crls-design/M8-Minima/docs/notes/design review.xlsx

Sheet: Schematic
Sheet | Area | Checked | Against | Notes
top | architecture
 | interconnection
power map | every rail accounted for
 | sequencing
 | peripheral levels
power input | port pinout | 2026-08-30
 | pd sink config | 2026-08-30 | datasheet | https://doc.chipmall.com/datasheet/rev_2412151944_hynetek-husb237-aa001-dn06r_c22909579.pdf
 | pd sink connection | 2026-08-30
 | buck feedback | 2026-08-30
 | buck bootstsrap | 2026-08-30
 | buck compensation | 2026-08-30
 | decoupling caps | 2026-08-30
pmic | input voltage bypass | 2026-08-30 | design checklist & evk | https://fscdn.rohm.com/en/products/databook/applinote/ic/power/switching_regulator_system/bd71847amwv_platformdesign_an-e.pdf
 | output bypass caps | 2026-08-30
 | pull ups | 2026-08-30
 | crystal | 2026-08-30
 | pinout | 2026-09-03 | datasheet
m8 power | symbol pinout | 2026-08-30 | datasheet
 | bypass caps | 2026-08-30 | evk
m8 io | symbol pinout | 2026-08-30 | datasheet
 | lpddr4 dq swapping | 2026-08-19 | RPA sheet | download here https://community.nxp.com/t5/i-MX-Processors-Knowledge-Base/i-MX-8M-Family-DDR-Tool-Release/ta-p/1104467
 | lpddr4 dqs dmi matched | 2026-08-21
 | lpddr4 channel ctrl addr matched | 2026-08-21
 | lpddr4 pinout | 2026-08-21 | datasheet table 69 | search for LPDDR4 keyword
 | ddr pin delay | 2026-08-21 | hardware guide | https://docs.nxp.com/bundle/IMX8MMHDG/page/topics/imx_8m_mini_ddr_package_delay.html
 | lpddr4 ref resistor | 2026-08-21 | design checklist | https://docs.nxp.com/bundle/IMX8MMHDG/page/topics/design_checklist_table.html
 | tsensor | 2026-08-21 | evk
 | usb ref resistor | 2026-08-19 | design checklist | https://docs.nxp.com/bundle/IMX8MMHDG/page/topics/design_checklist_table.html
 | vbus | 2026-08-19 | pintool | screenshot embedded
 | usb1 pinout | 2026-08-19 | pintool | screenshot embedded
 | usb2 pinout | 2026-08-19 | pintool | screenshot embedded
 | pcie pinout | 2026-08-19 | pintool | screenshot embedded
 | pcie ref resistor | 2026-08-21 | design checklist | https://docs.nxp.com/bundle/IMX8MMHDG/page/topics/design_checklist_table.html
 | uart pinout | 2026-08-21 | pintool | screenshot embedded
 | ethernet pinout | 2026-08-26 | pintool | screenshot embedded
 | i2c1 pinout | 2026-08-19 | pintool | screenshot embedded
 | i2c1 pull ups to NVCC I2C (pmic) | 2026-08-19 | pmic design checklist | pull ups located on pmic sheet
 | sd1 pinout | 2026-08-19 | pintool | screenshot embedded
 | sd2 pinout | 2026-08-19 | pintool | screenshot embedded
 | crystal resonator | 2026-08-21 | evk schematic
 | io level matched | 2026-08-21
m8 boot config | jtag pullups | 2026-08-30 | evk
 | jtag pins | 2026-08-30
 | boot mode | 2026-08-31 | datasheet
 | boot config | 2026-08-31 | datasheet
lpddr4 ram | symbol pinout | 2026-08-21 | datasheet
 | power | 2026-08-21
 | harness | 2026-08-21
 | odt | 2026-08-21 | hardware guide
 | zq | 2026-08-21 | hardware guide
ethernet | symbol pinout | 2026-08-21 | datasheet
 | jack termination | 2026-08-21
 | rgmii level | 2026-08-21
 | bootstraping | 2026-08-21
 | reset | 2026-08-21
 | regulator | 2026-08-21
flash | symbol pinout | 2026-08-21
 | emmc power | 2026-08-21
 | emmc pinout | 2026-08-21
 | sd power | 2026-08-21
 | sd pinout | 2026-08-21
 | pull ups | 2026-08-21
usb hub | symbol pinout | 2026-08-21 | datasheet
 | reset | 2026-08-21
 | power | 2026-08-21
 | bootstrap | 2026-08-21 | checklist
 | ref resistor | 2026-08-21 | checklist
 | diff pair polarity | 2026-08-21
 | usb detect | 2026-08-21
 | test pin | 2026-08-21 | checklist
 | crystal | 2026-08-21 | stm evk | https://www.st.com/resource/en/schematic_pack/mb1936-mp257f-x-d01-schematic.pdf
usb device port | symbol pinout | 2026-08-21 | datasheet
 | cc lines | 2026-08-21
 | polarity | 2026-08-21
 | vbus | 2026-08-21
usb host port | symbol pinout | 2026-08-21 | datasheet
 | cc lines | 2026-08-21
 | polarity | 2026-08-21
 | vbus | 2026-08-21
 | power switch | 2026-08-21 | datasheet
 | current limit | 2026-08-21
pcie | usb pinout | 2026-08-21
 | pcie pinout | 2026-08-21
 | sidebands | 2026-08-21
 | io level | 2026-08-21
 | pull resistors | 2026-08-21
uart | polarity | 2026-08-21
 | uart direction | 2026-08-21
 | power | 2026-08-21
 | io level | 2026-08-21
 | tx ac coupling | 2026-08-21

Sheet: Layout
Area | Checked | Against | Notes

Sheet: Today
2026-09-07
