crls-design/M8-Minima/docs/schematic.pdf

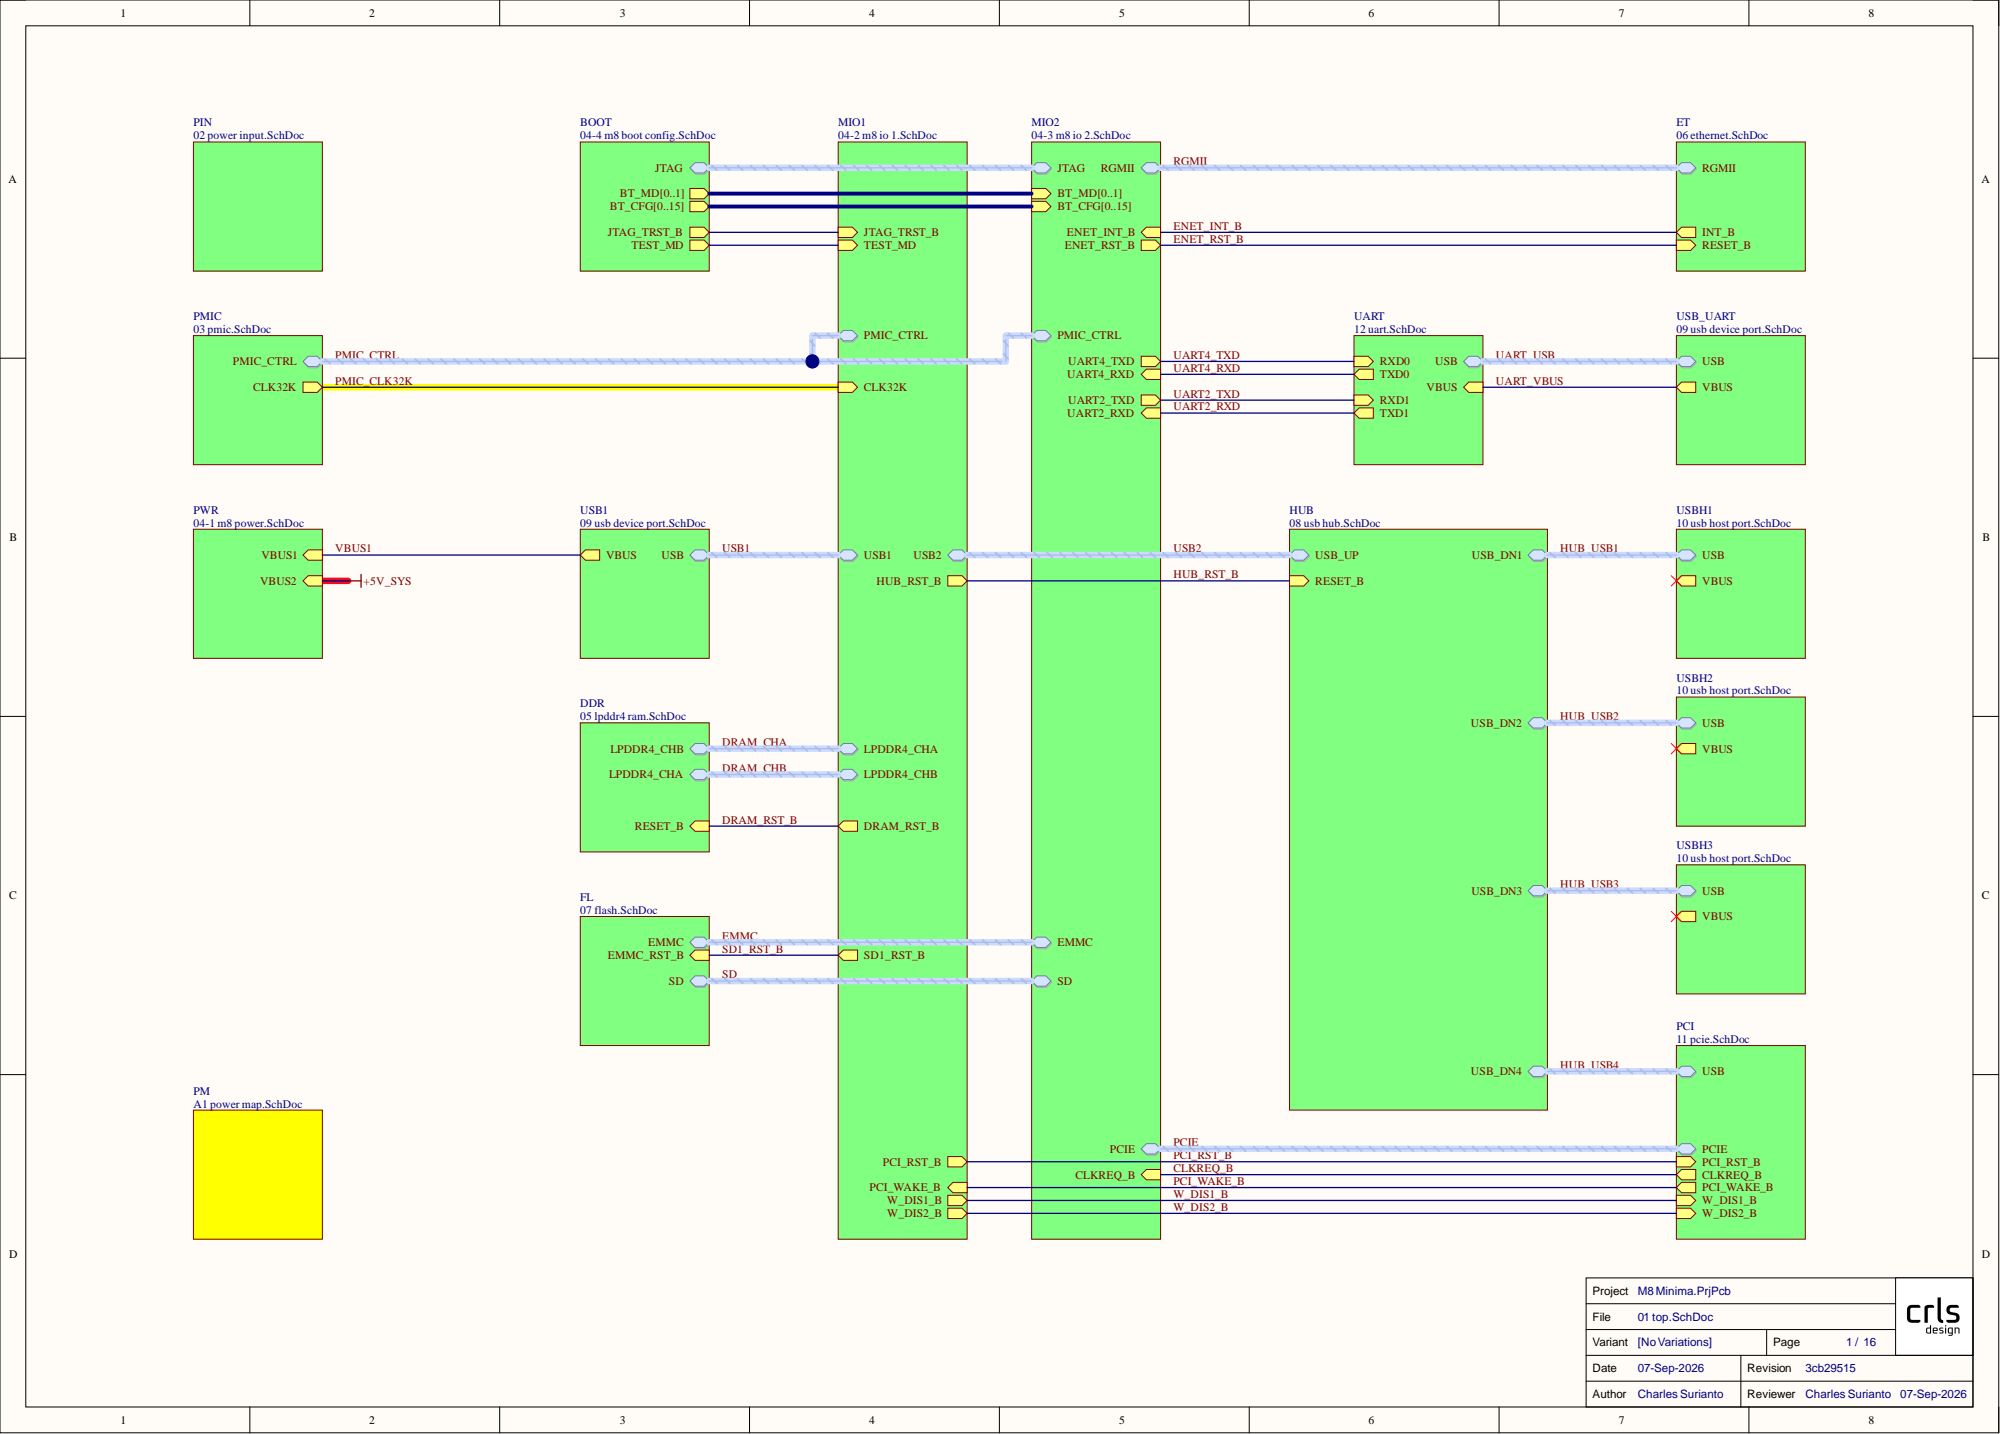
[picture p5: page 1]

JTAG_TRST_B TEST_MD PMIC_CTRL

USB_UART
09 usb device port.SchDoc

PMIC_CLK32K | UART4_RXD | UART_VBUS

USB1

USBH1
10 usb host port.SchDoc

USBH2

USBH3

W_DIS1_B
W_DIS2_B

Variant [No Variations] | Page

Date 07-Sep-2026 | Revision 3cb29515

Author Charles Surianto | Reviewer Charles Surianto 07-Sep-2026

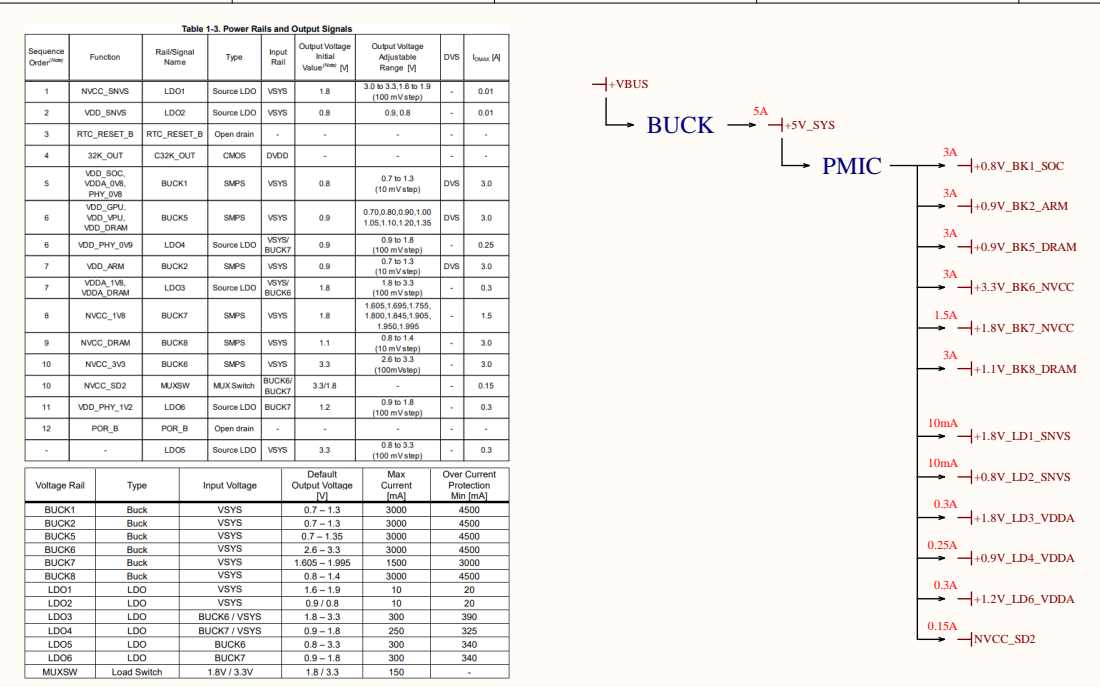
[picture p6: page 2]

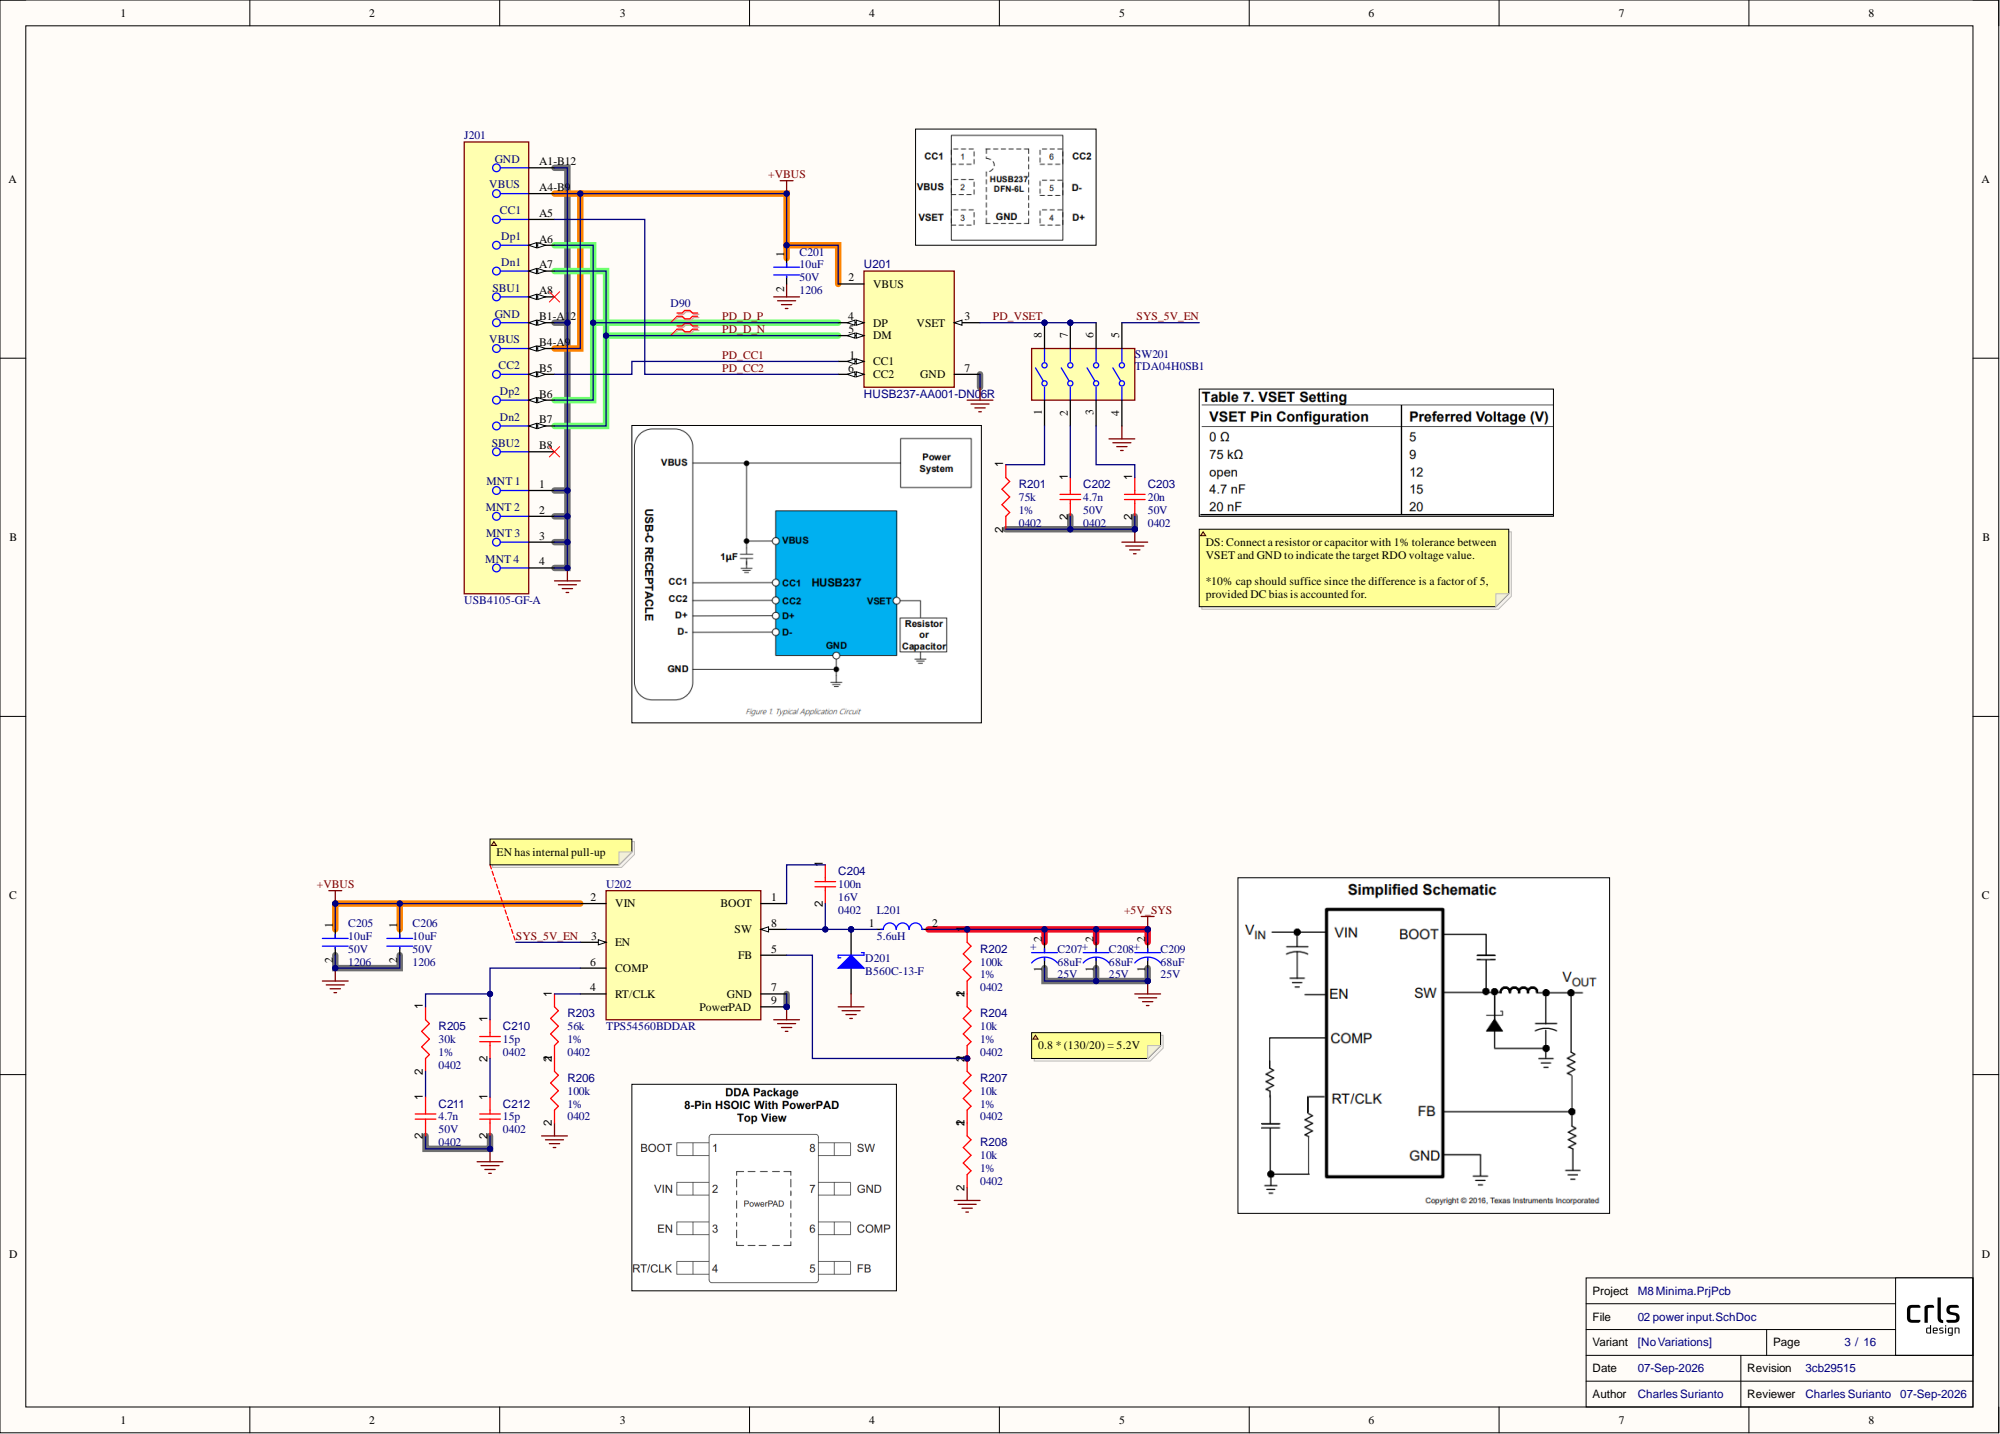
[picture p7: page 3]

PD_CC1 | CC1 1
PD_CC2

DS: Connect a resistor or capacitor with 1% tolerance between
VSET and GND to indicate the target RDO voltage value.

*10% cap should suffice since the difference is a factor of 5,
provided DC bias is accounted for.

EN has internal pull-up

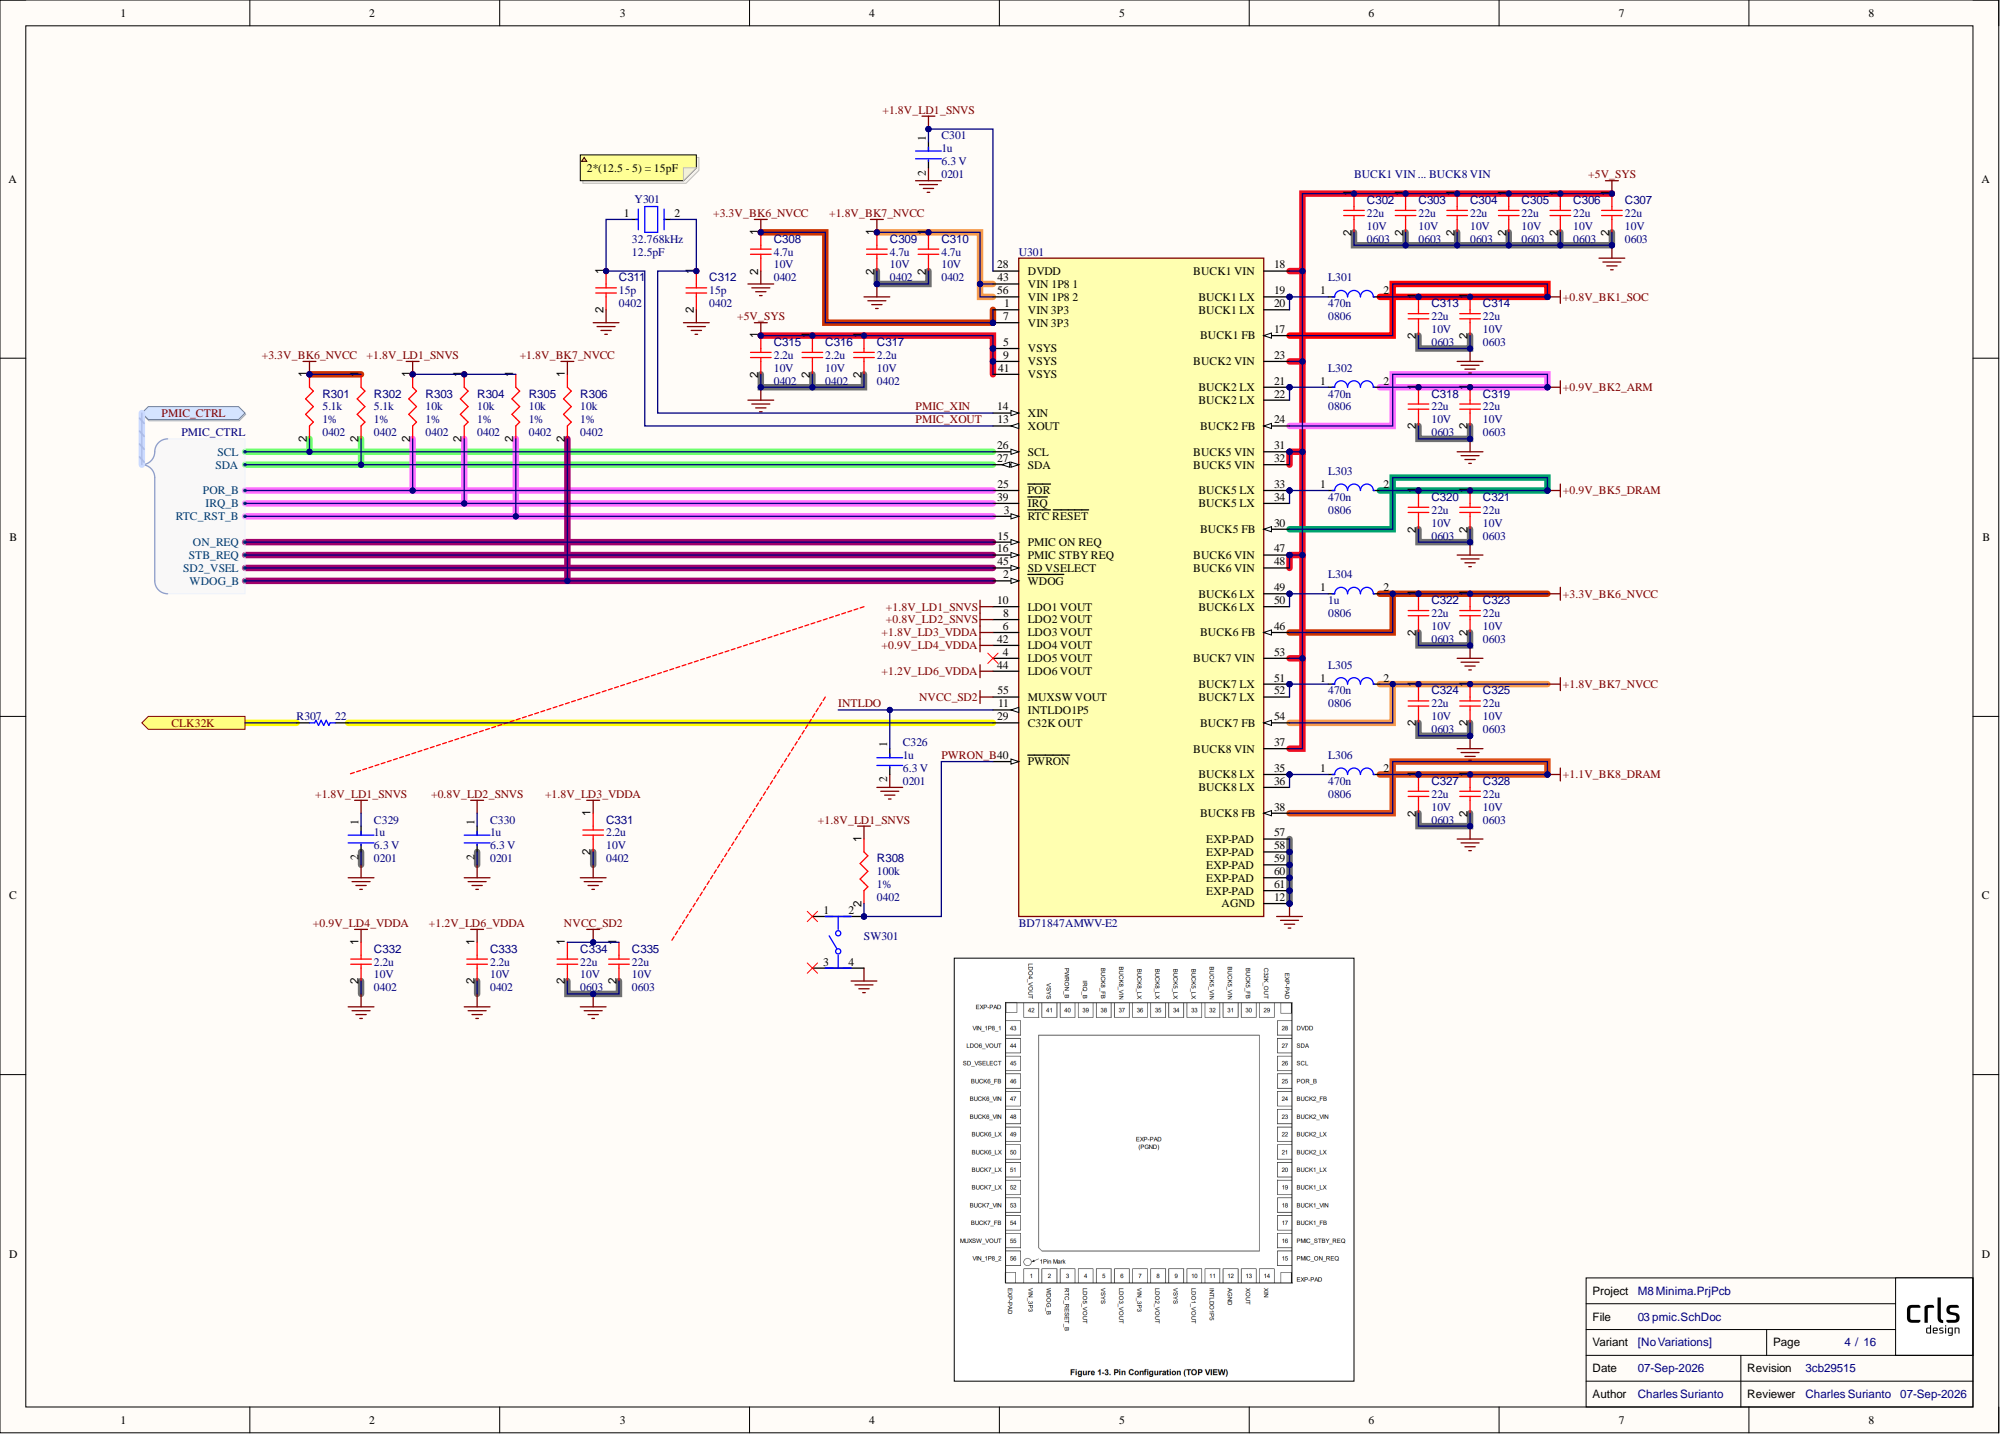
[picture p8: page 4]

2 5 | 3 3 3 4
3 | 3 0

4 5 | 4 8
2 | 4 9

5 1
5 2 | 4 7 0 n 0 8 0 6

Varian t [ No Variations ]

Dat | Revis i o n

Autho r | Review e Charles Suriant o 07-Sep-202

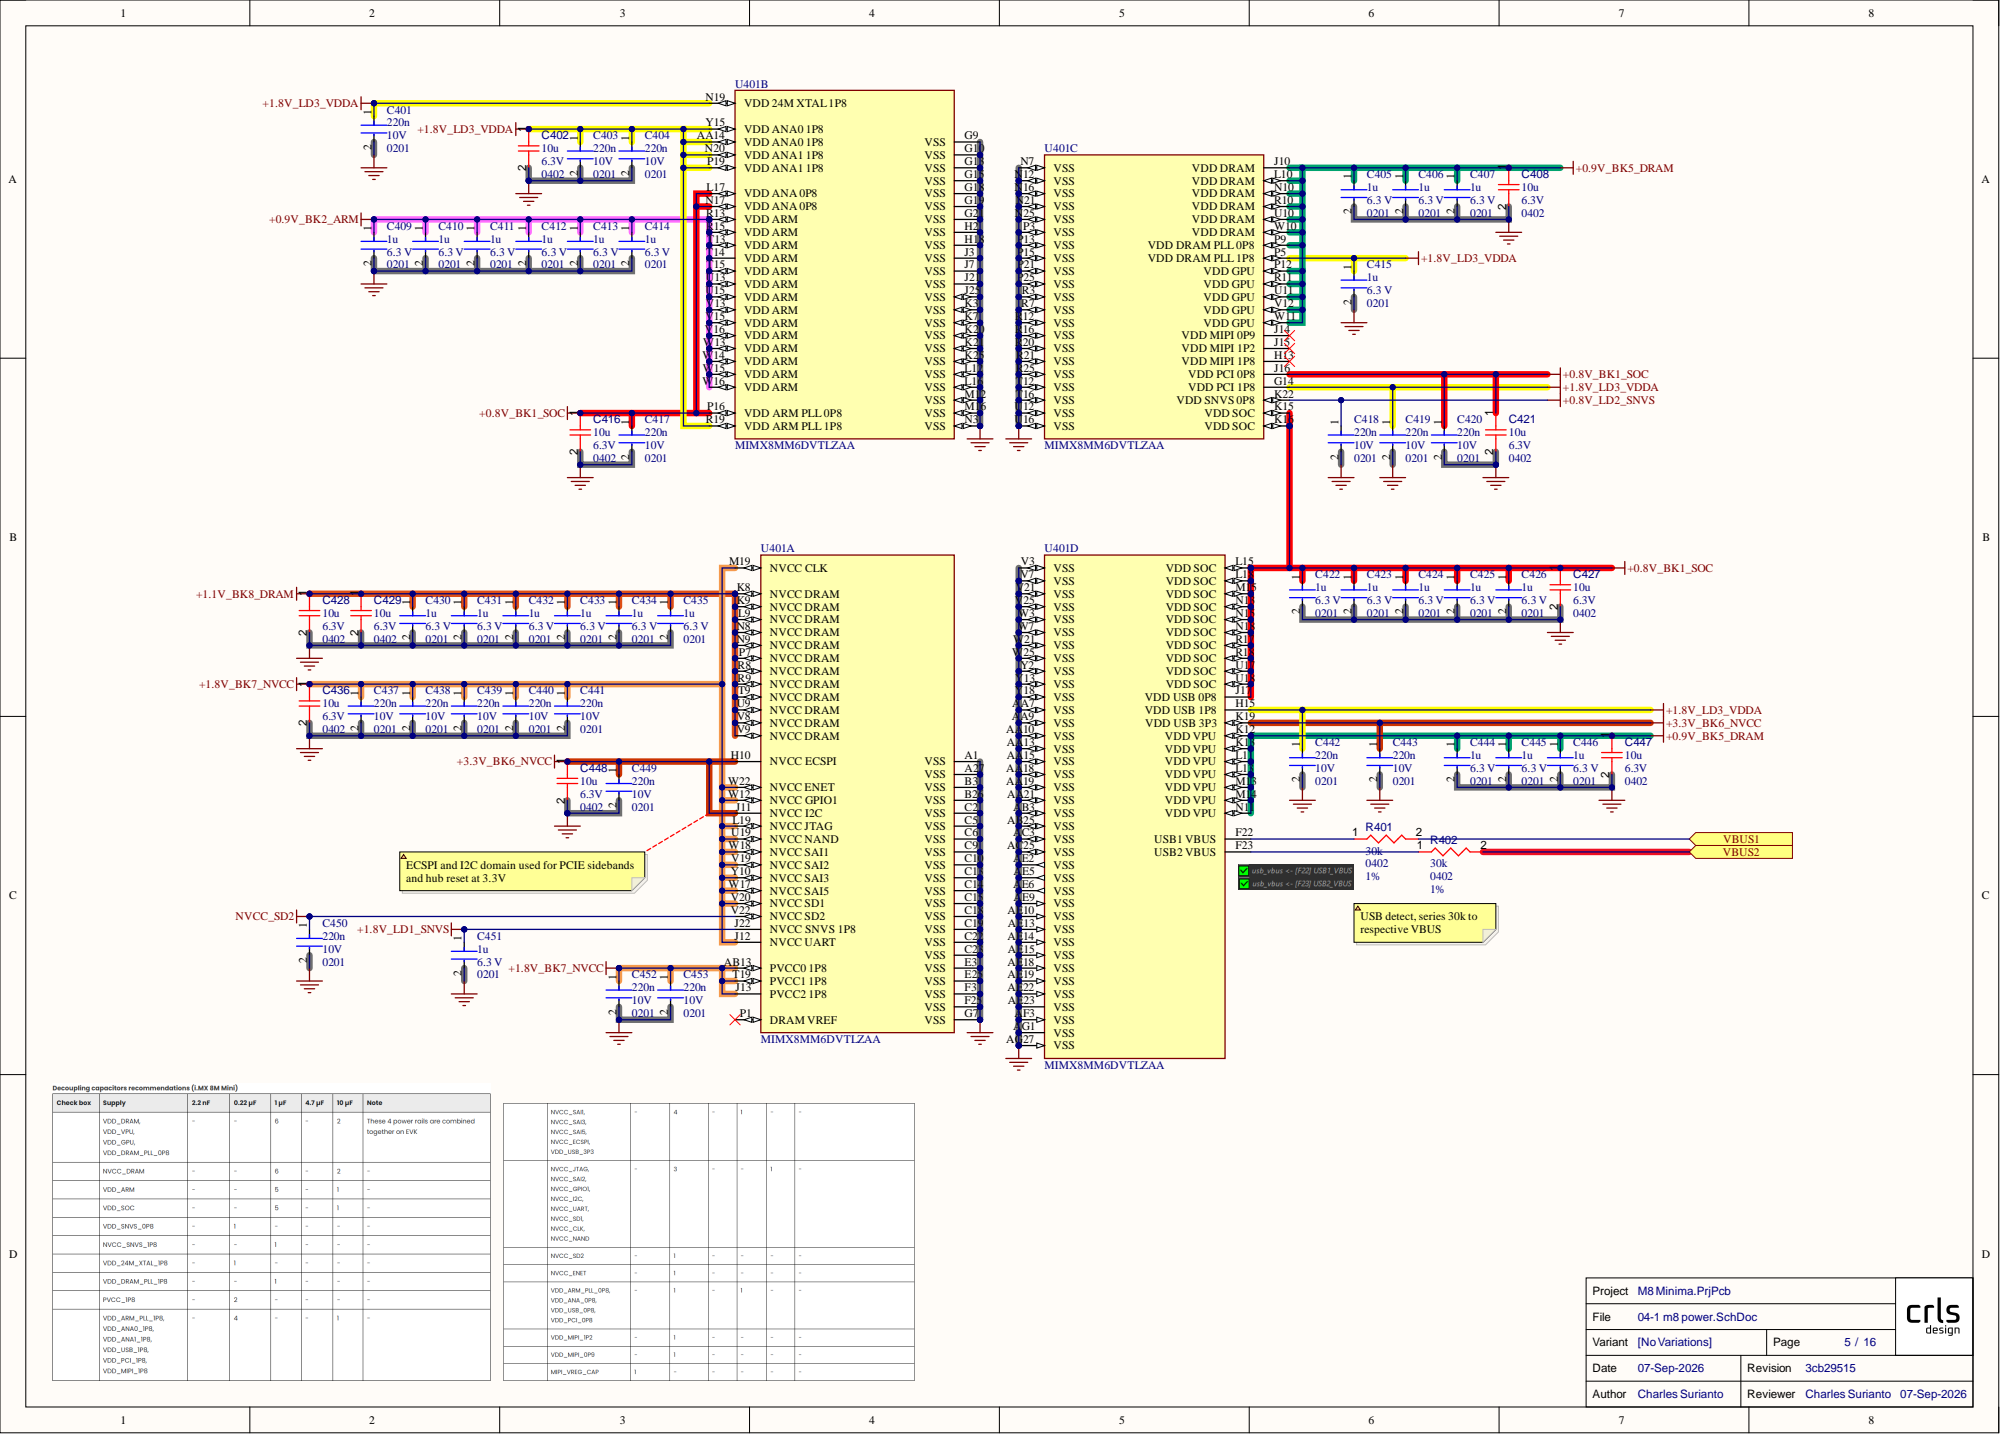
[picture p9: page 5]

ECSPI and I2C domain used for PCIE sidebands
and hub reset at 3.3V

USB detect, series 30k to
respective VBUS

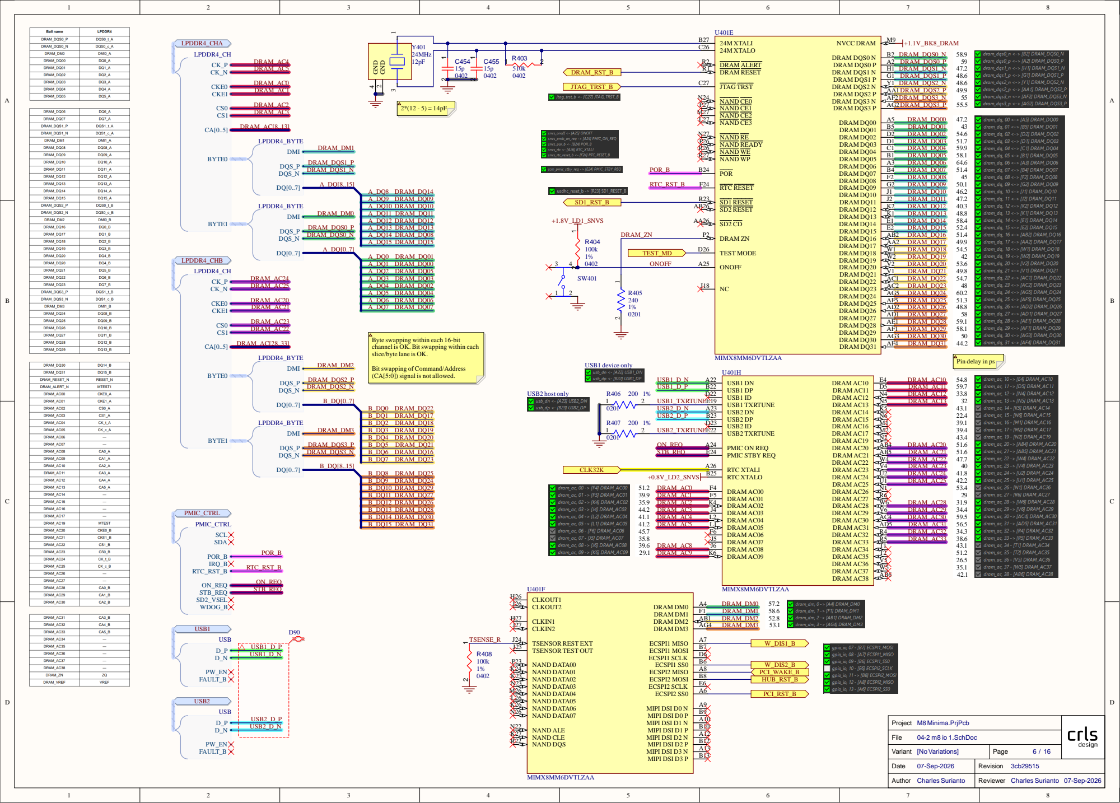
[picture p10: page 6]

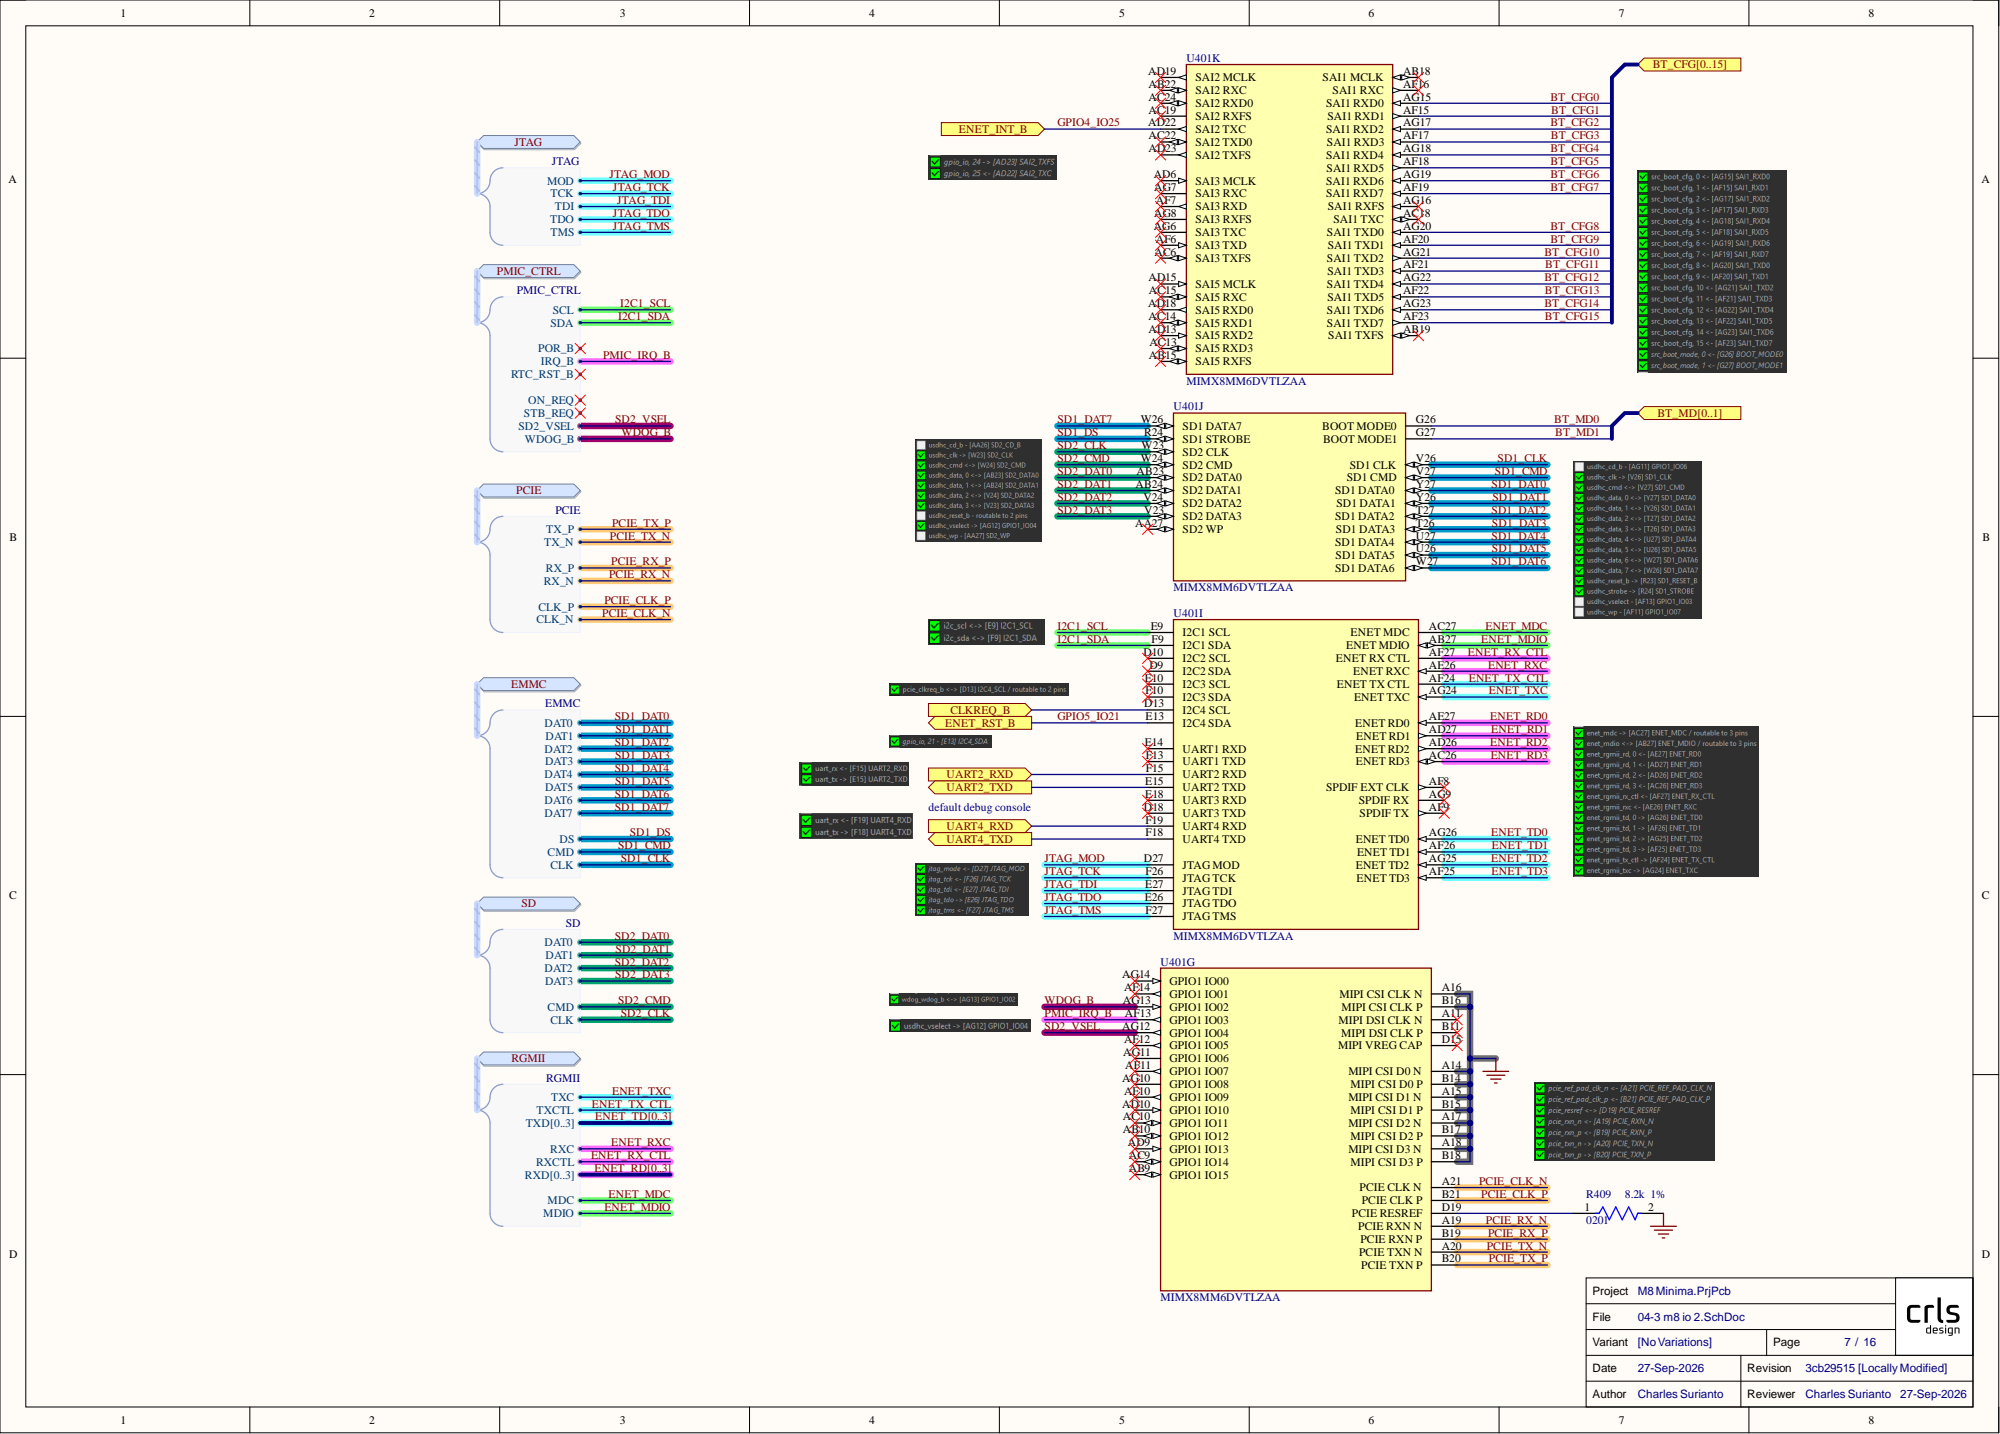
[picture p11: page 7]

[ No Variations ]

[Locally Modified]

o 27-Sep-202

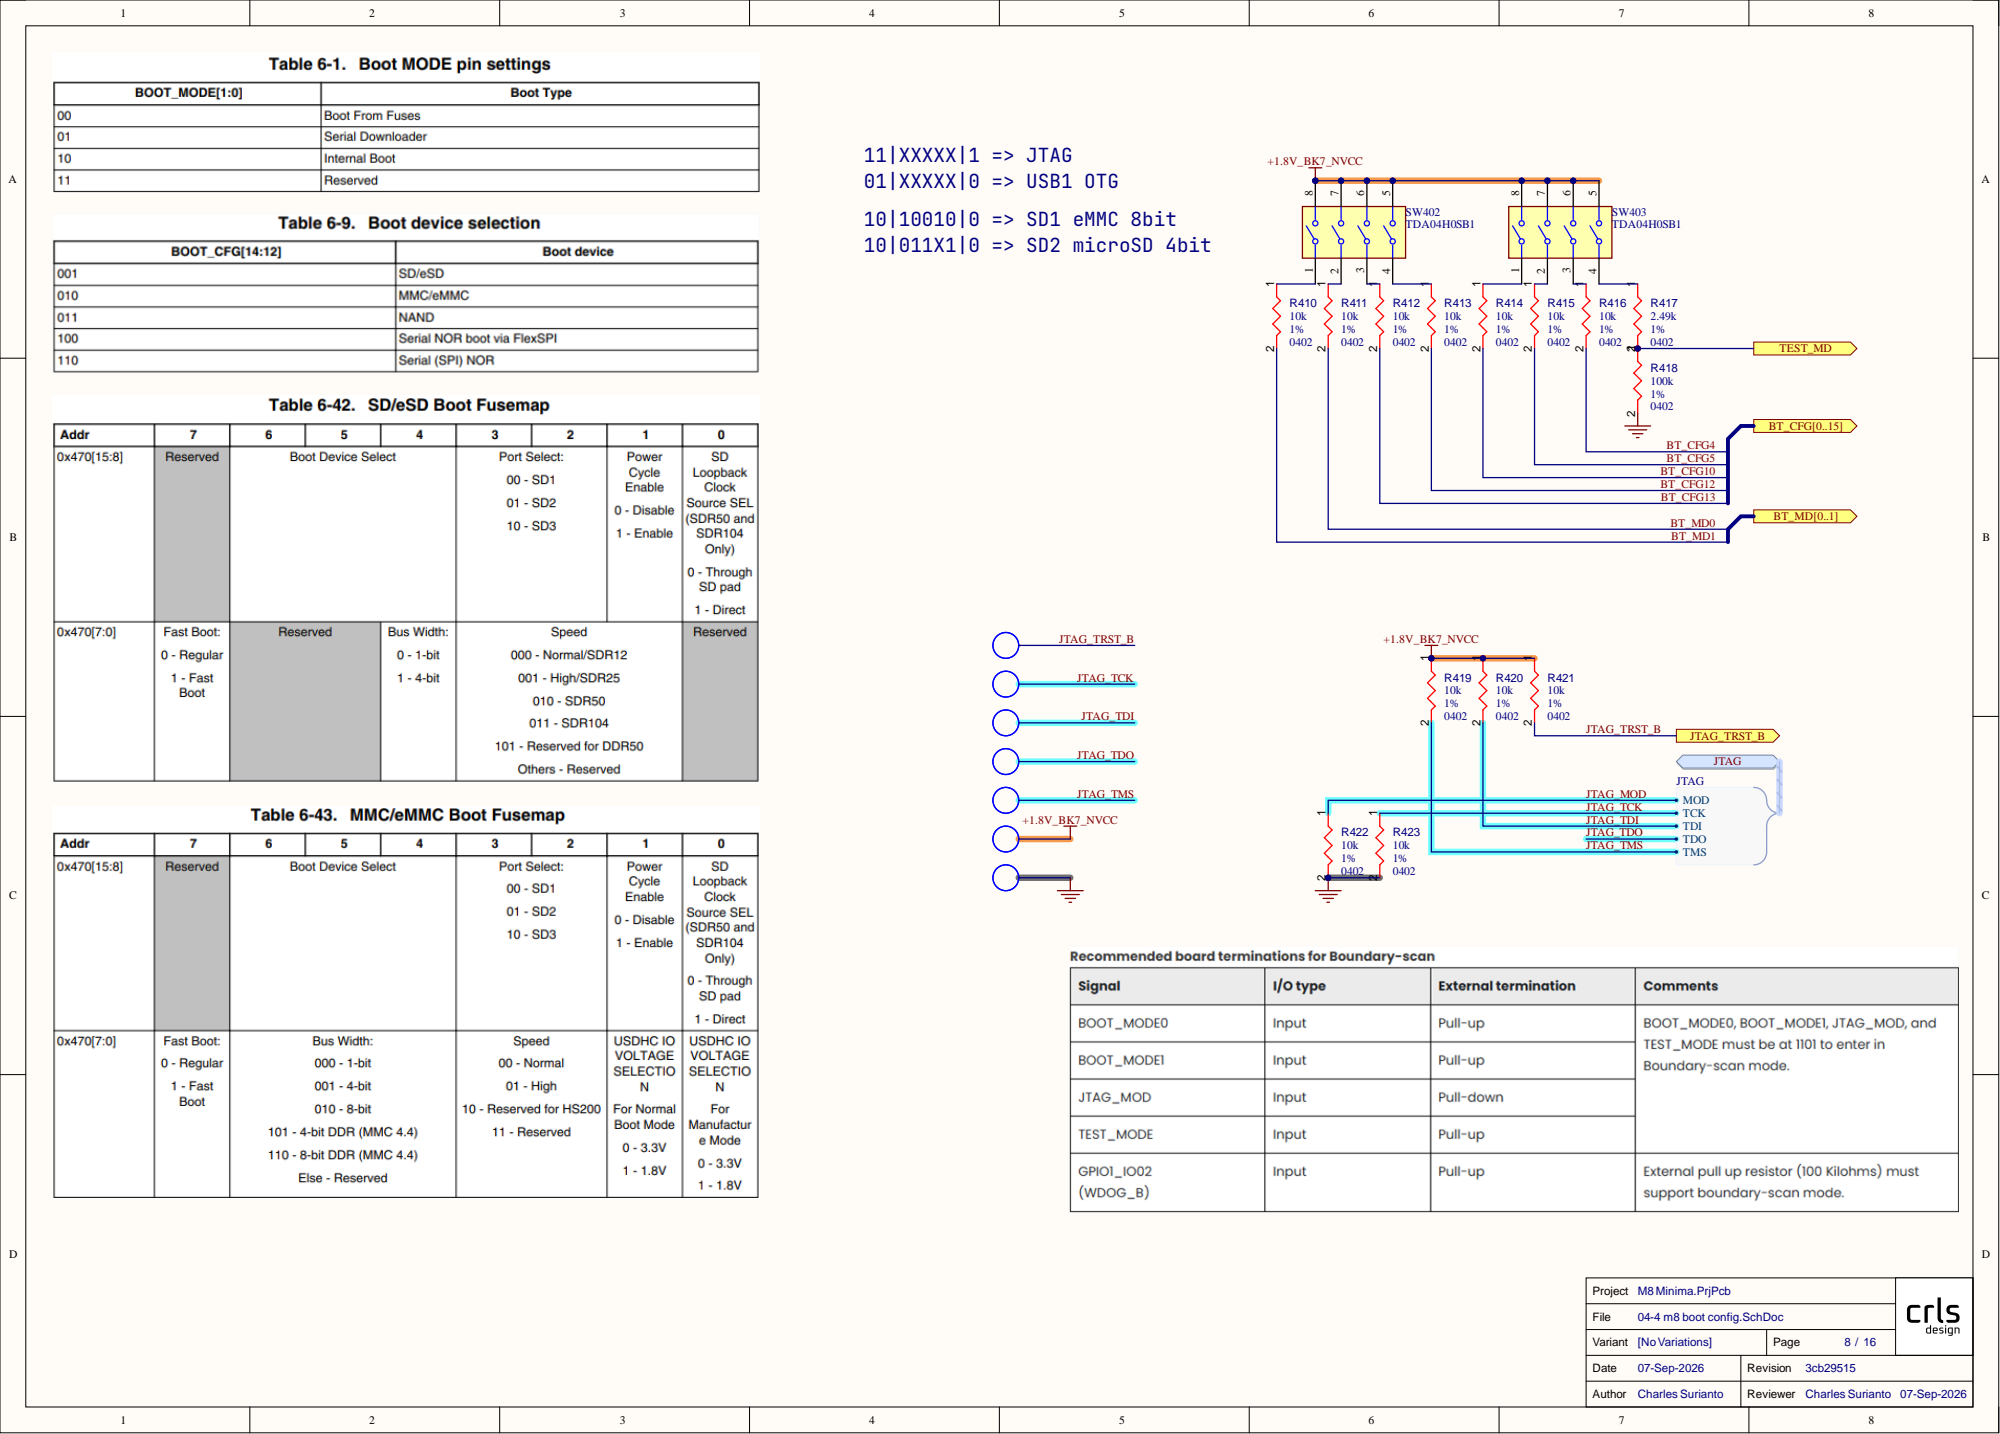
[picture p12: page 8]

JTAG_TCK
JTAG_TDI

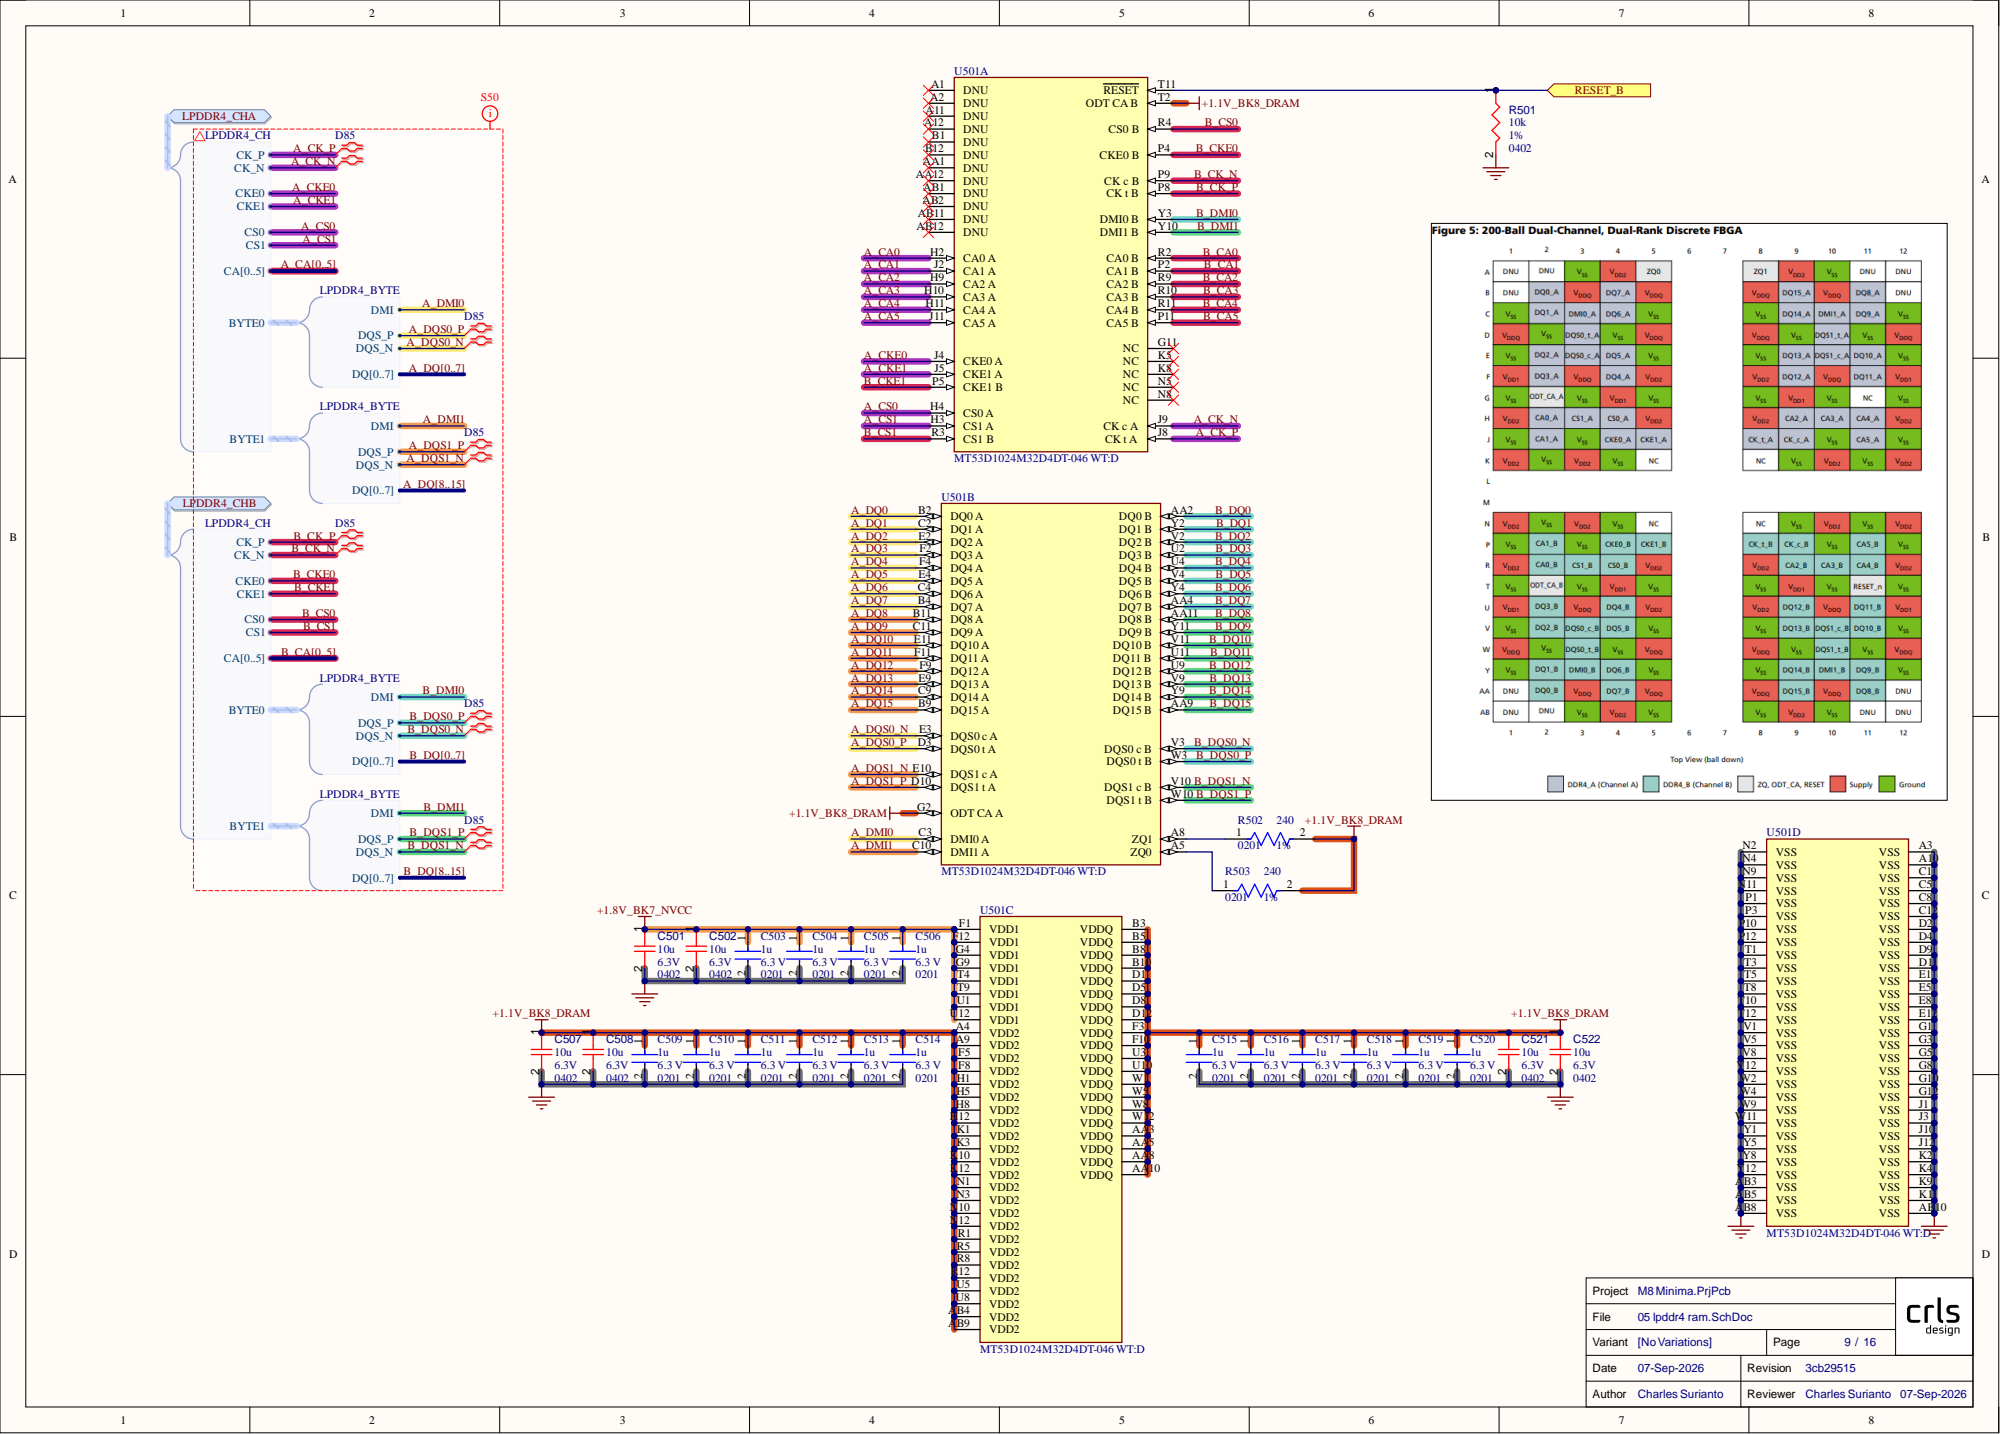
[picture p13: page 9]

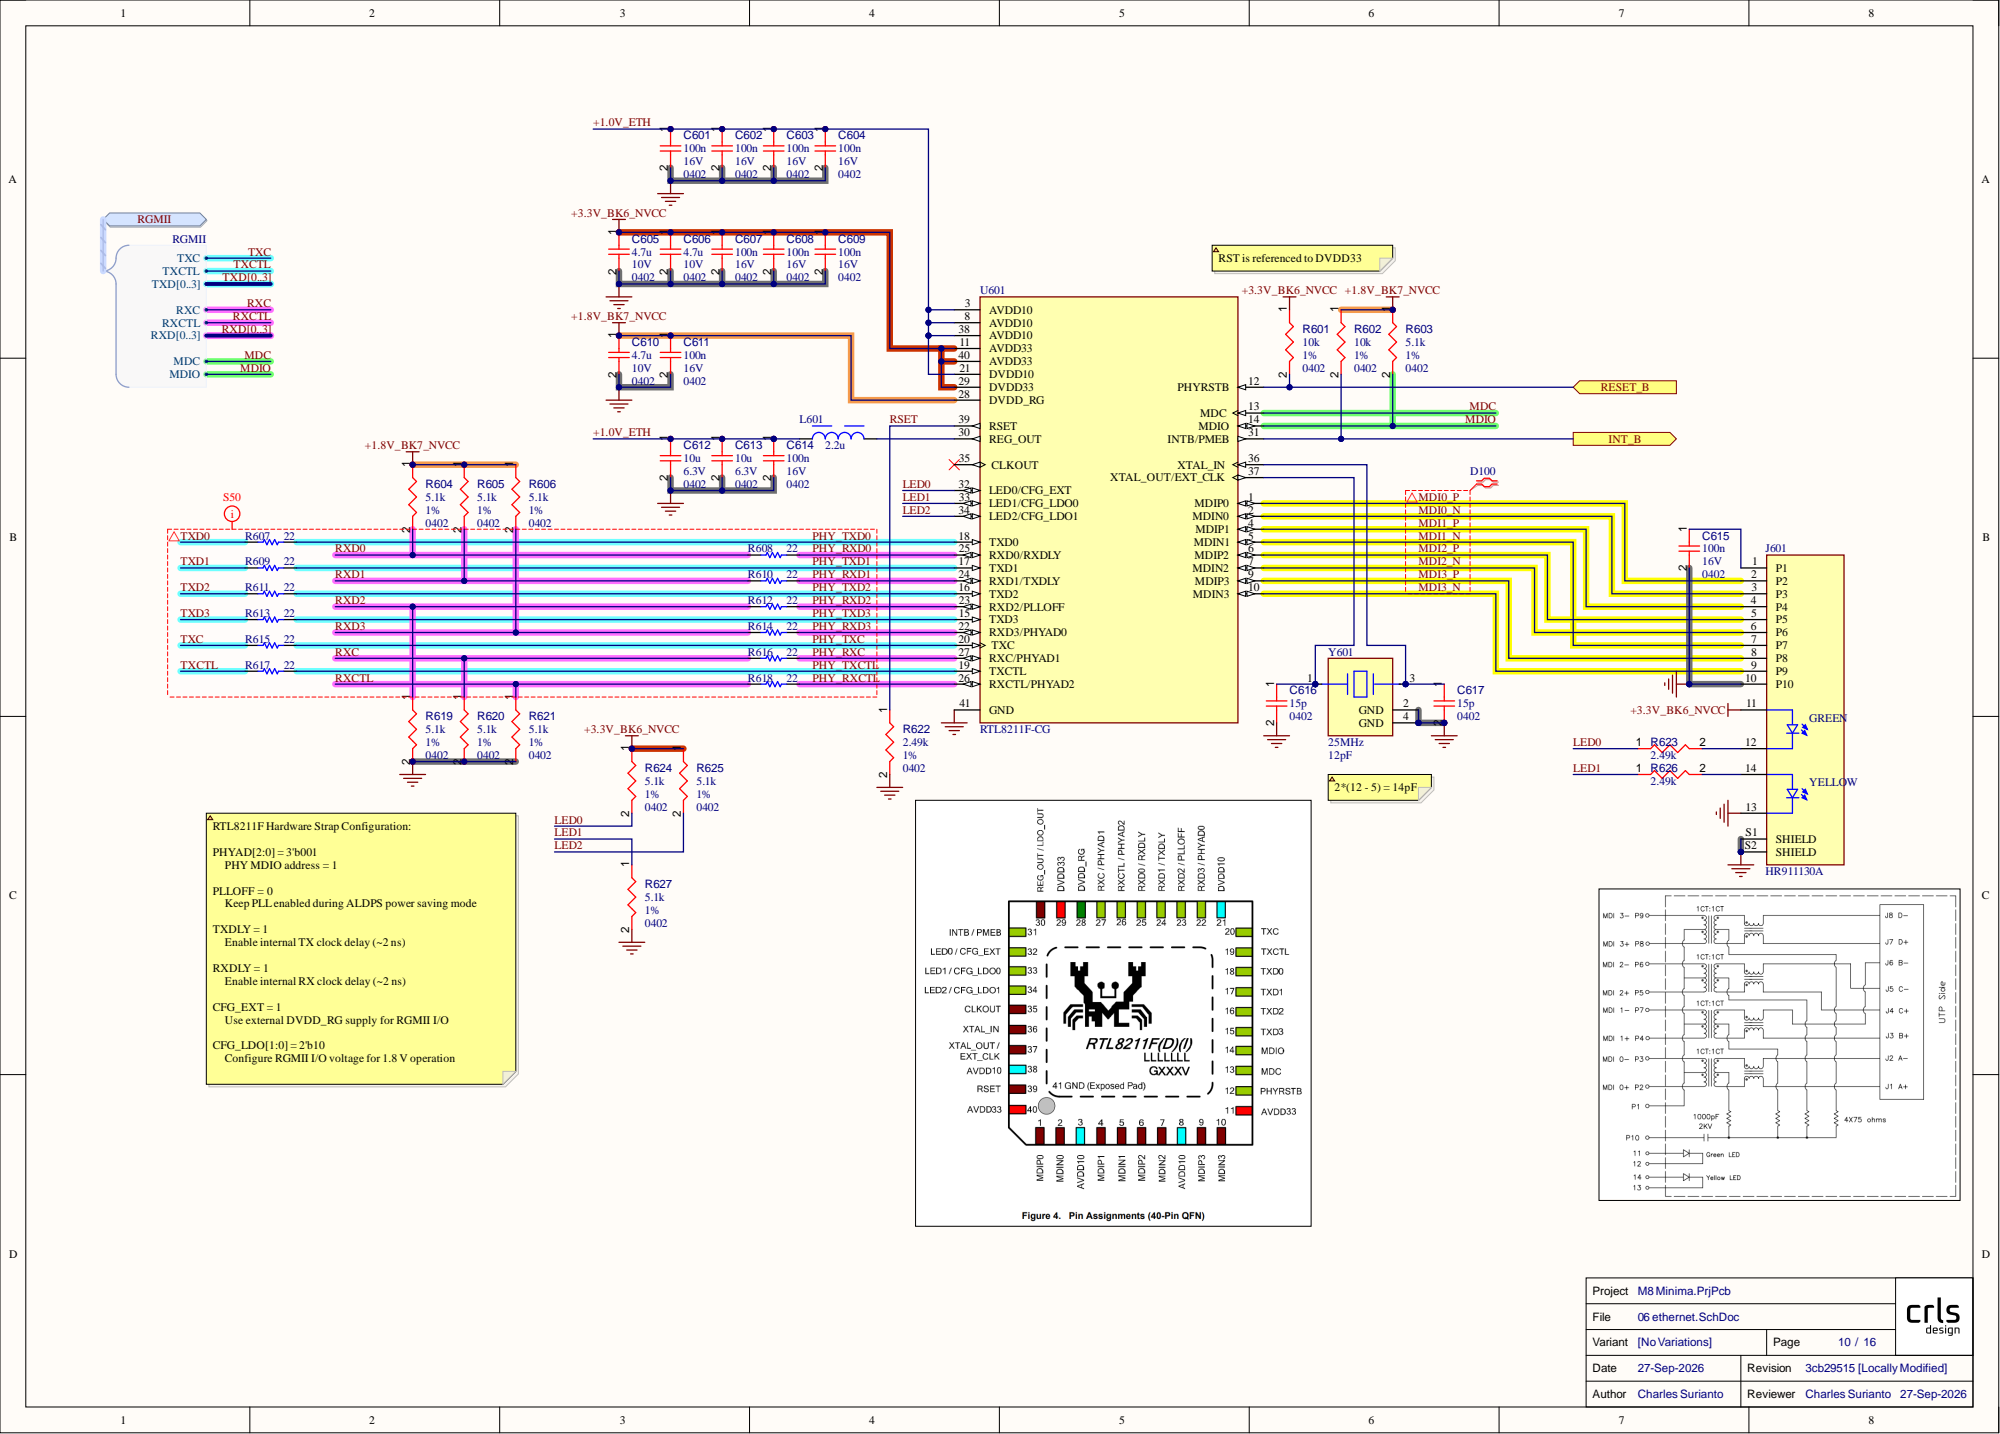
[picture p14: page 10]

3 8

4 0
2 1

2 | MDI0 _N
4 | MDI1 _P
5 | MDI1 _N | C61 5
6 | MDI2 _P | 1 0 0 n

9 | | MDI3 _P | 0 4 0 2 | 2
1 0 | | MDI3 _N | | 3

[ No Variations ]

[Locally Modified]

o 27-Sep-202

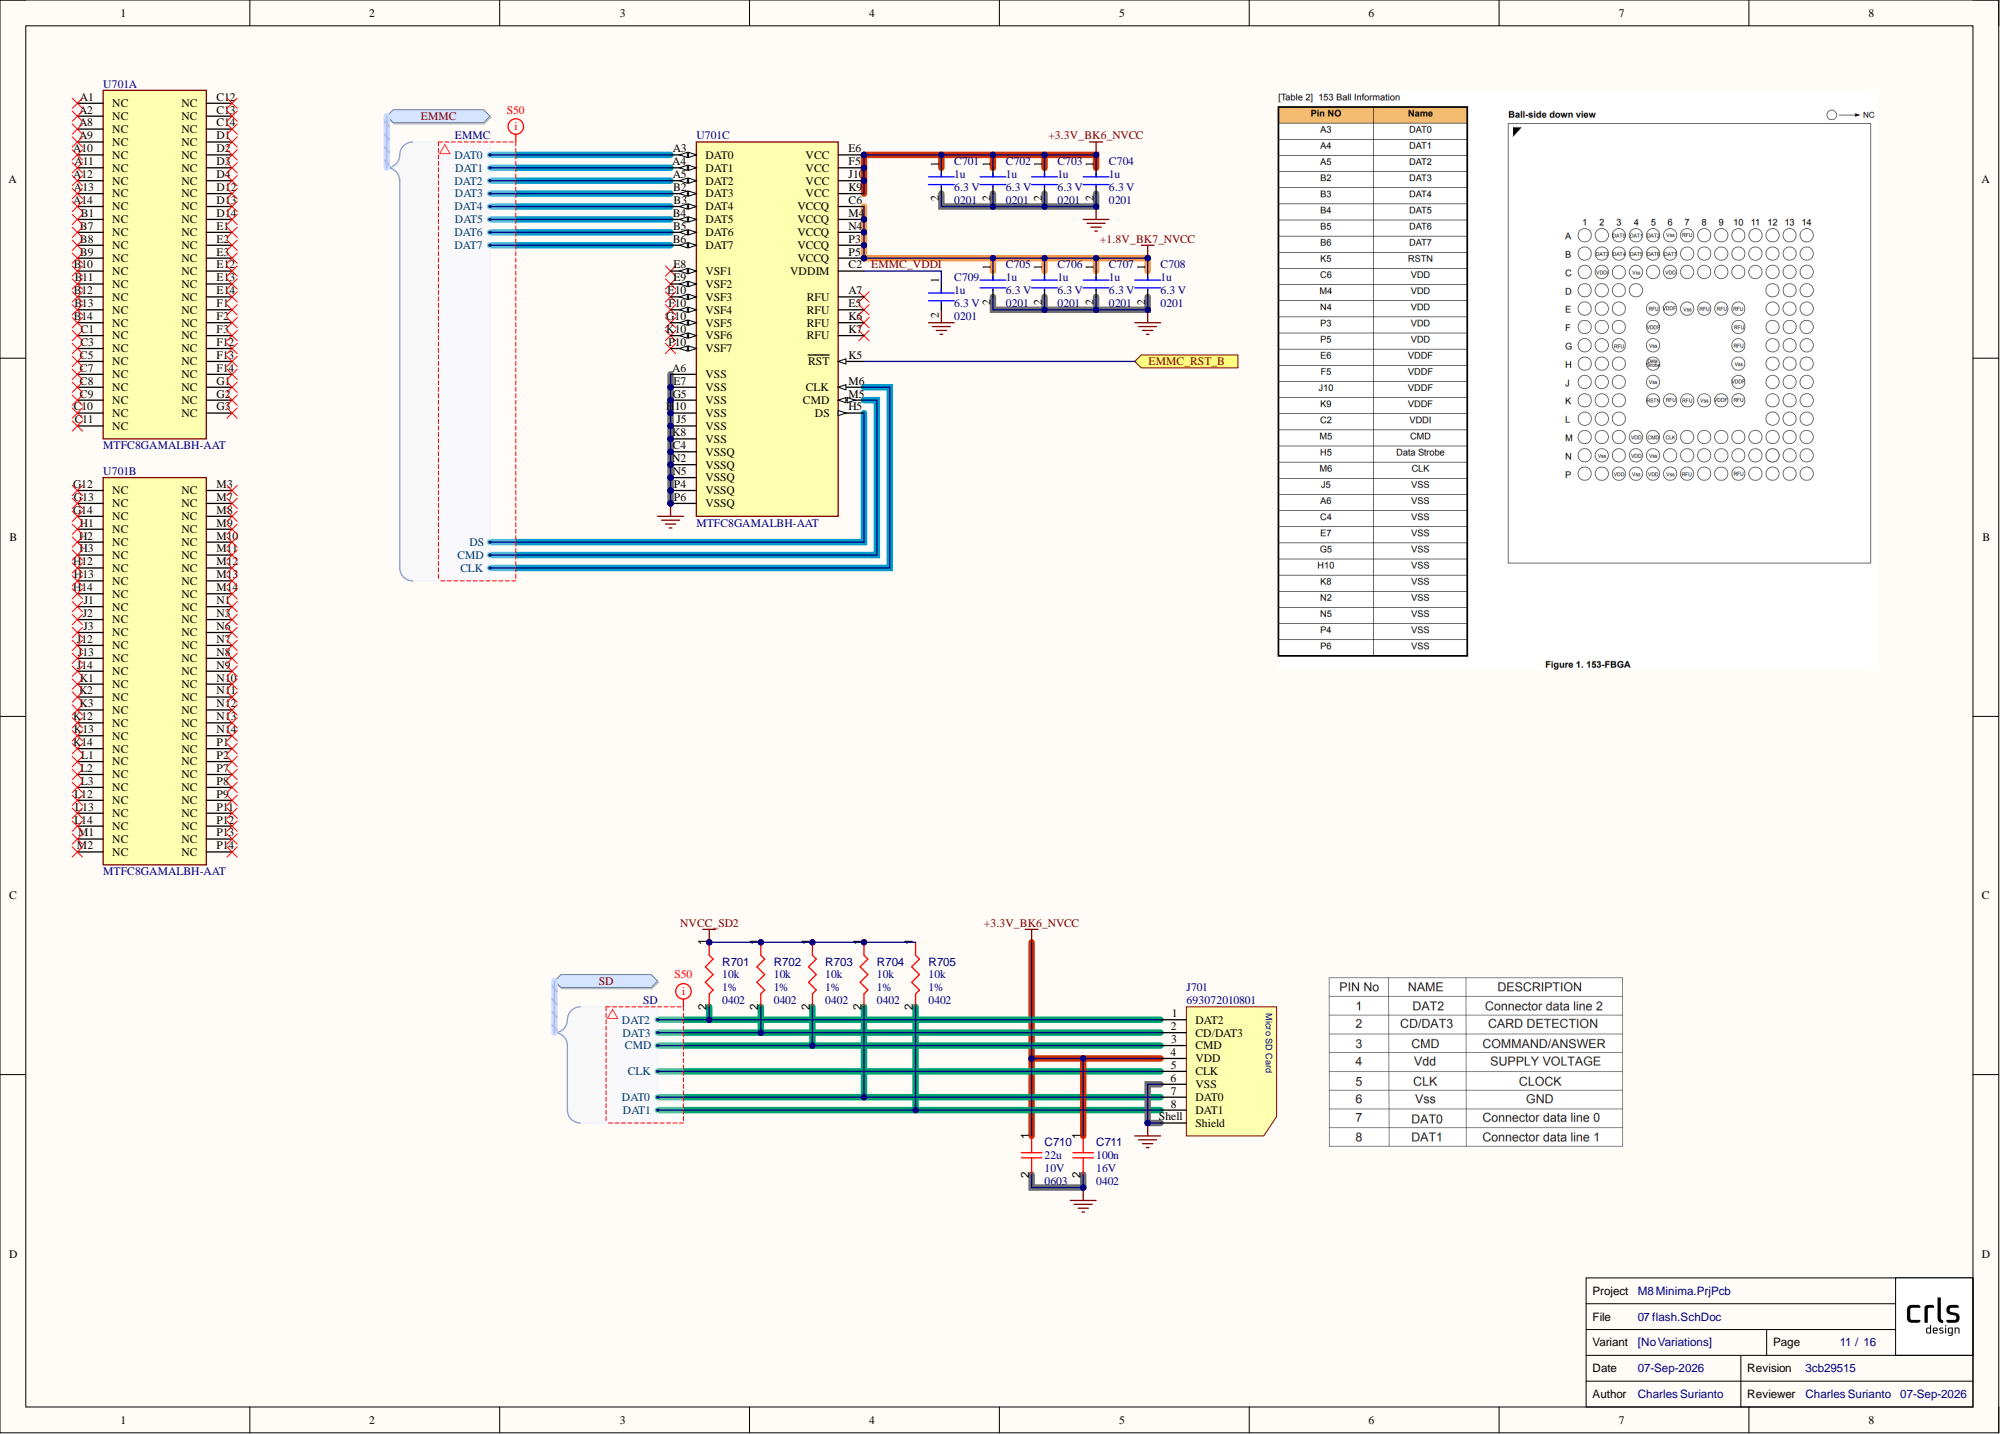
[picture p15: page 11]

VSS G5 CMD | M5

VSS J5

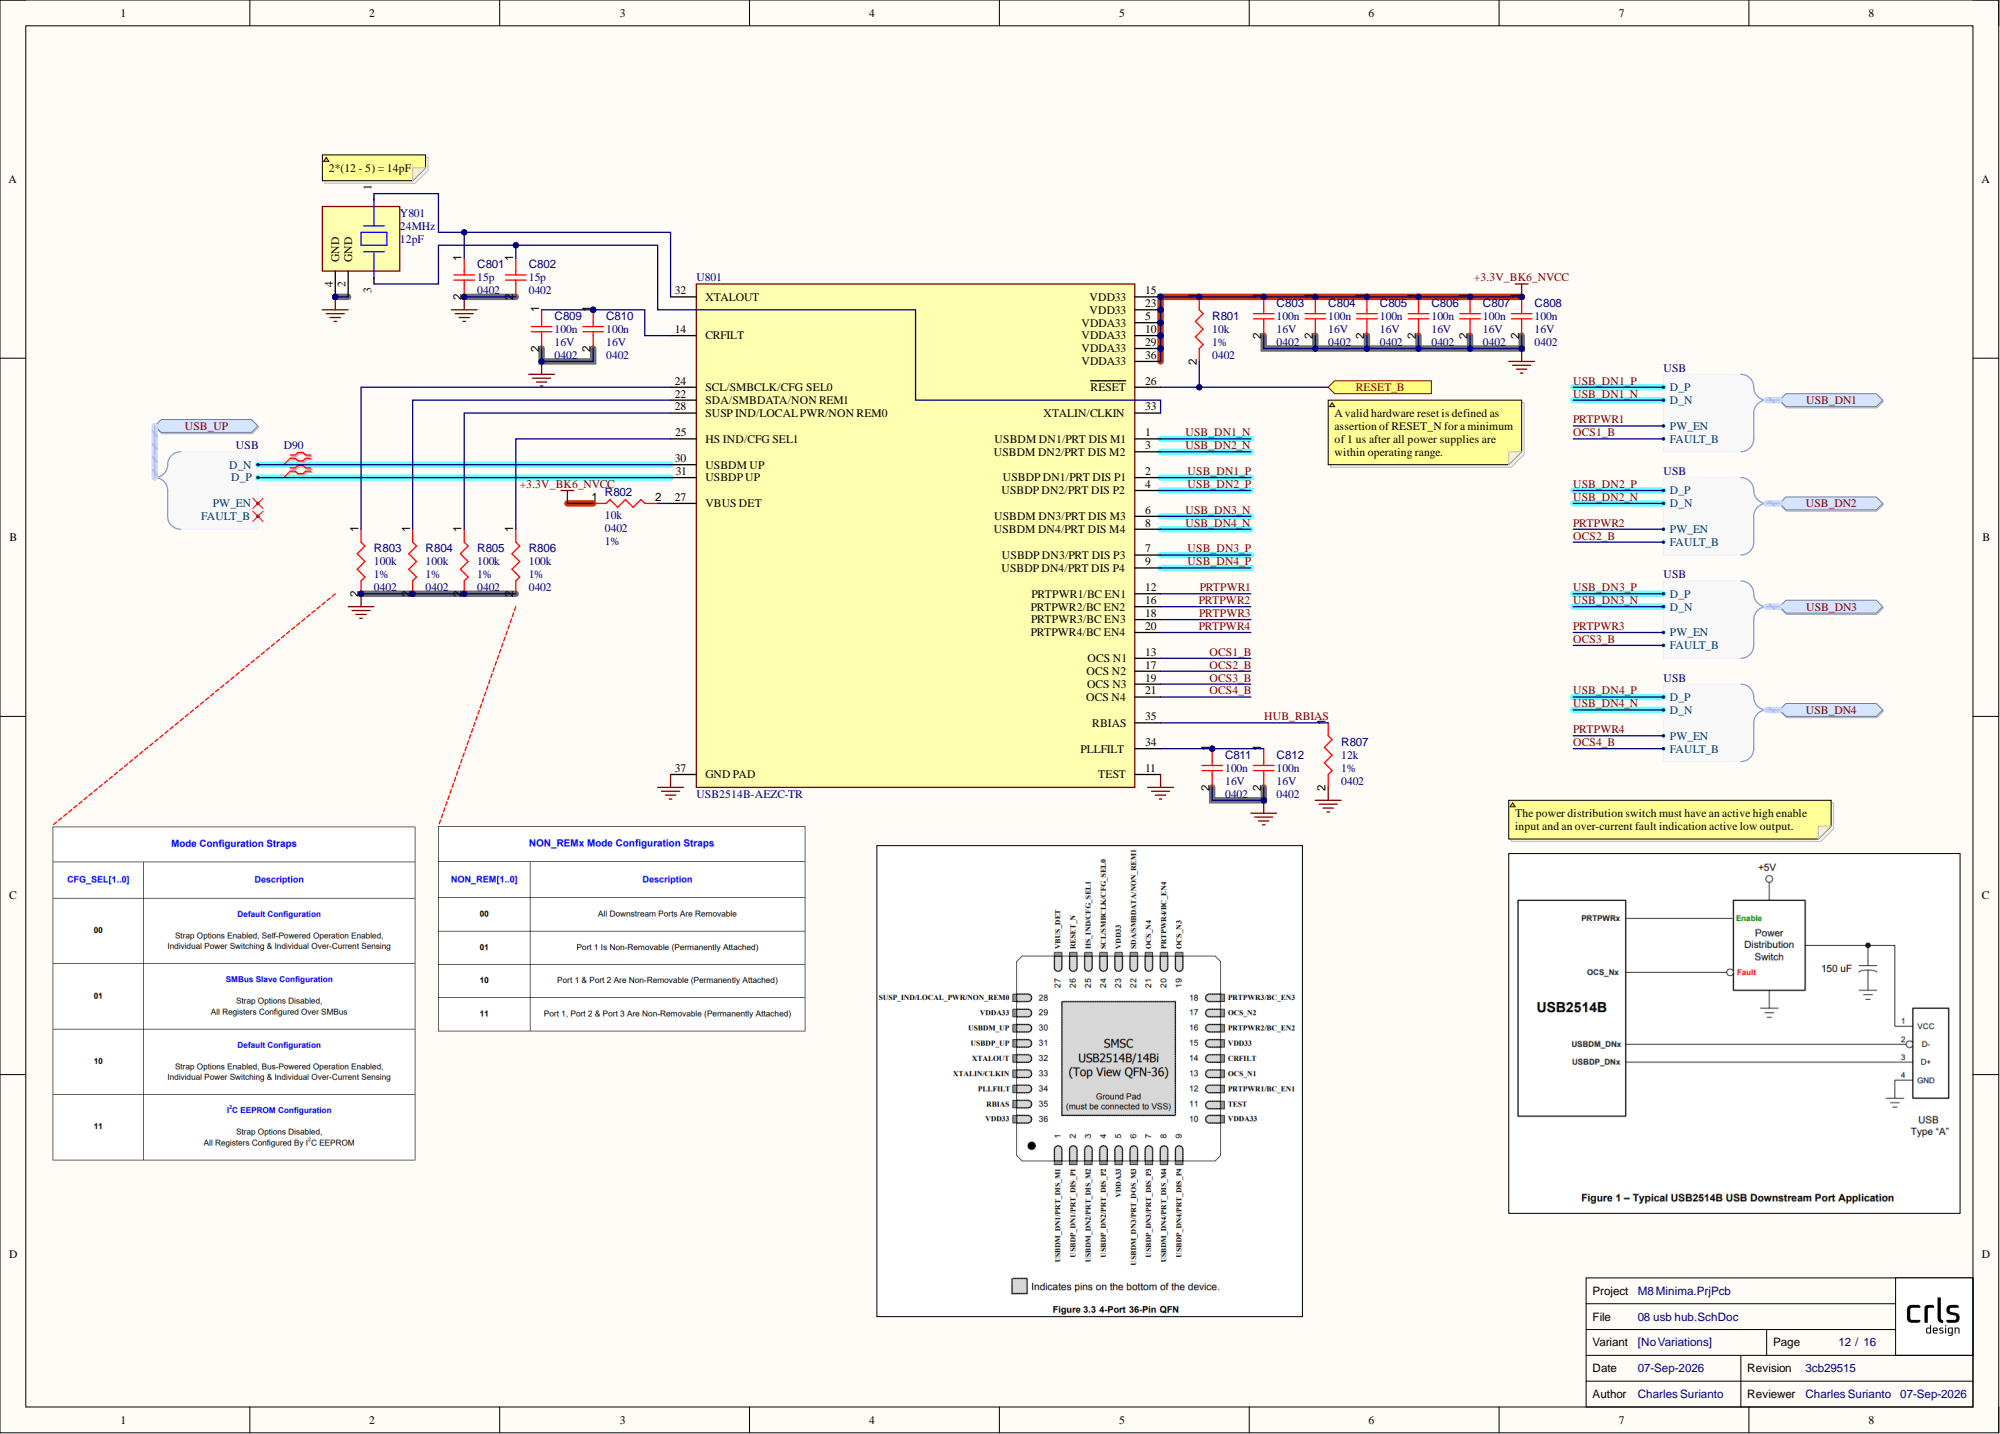
[picture p16: page 12]

2 2
2 8 | X TA LIN /CL KIN USBDM D N 1 /PRT DIS M1 USBDM D N 2 /PRT DIS M2 USBD P D N 1 /PRT DIS P1 USBD P D N 2 /PRT DIS P2 USBDM D N 3 /PRT DIS M3 USBDM D N 4 /PRT DIS M4 USBD P D N 3 /PRT DIS P3 USBD P D N 4 /PRT DIS P4 PRTPWR1 /BC E N 1 PRTPWR2 /BC E N 2 PRTPWR3 /BC E N 3 PRTPWR4 /BC E N 4 OCS N 1 OCS N 2 OCS N 3 OCS N 4 RBIA S PL LFILT T E S T | 3 3

08 usb hub.SchDoc [No Variations]

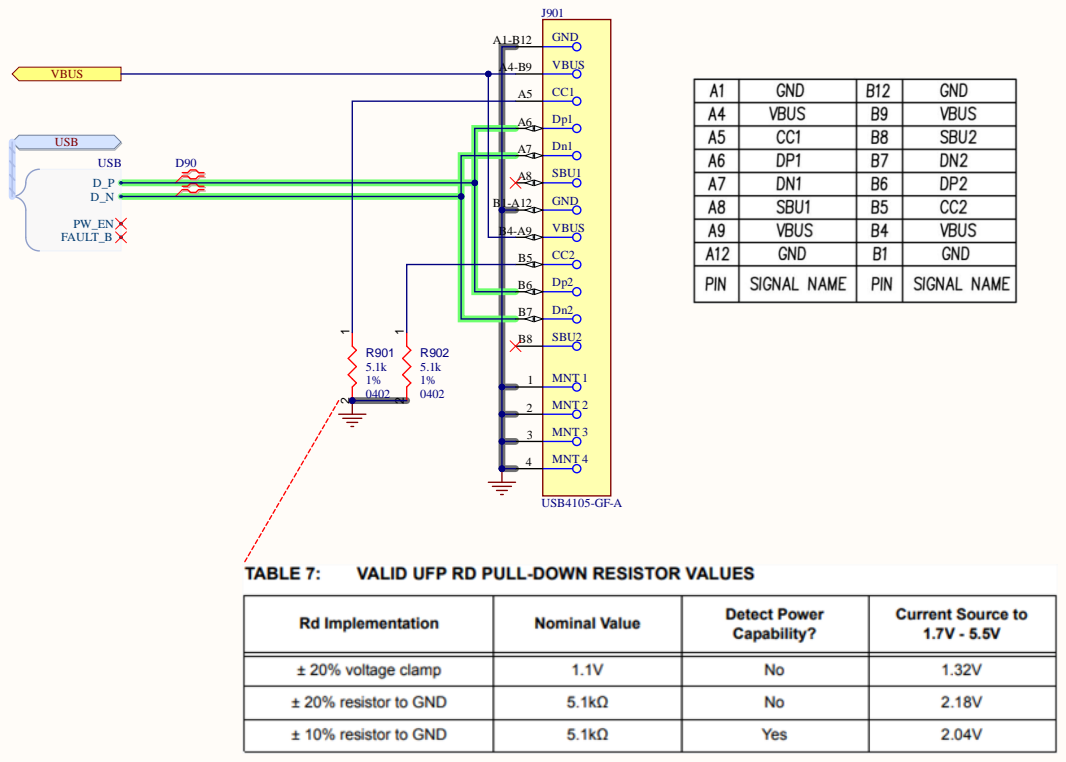
[picture p17: page 13]

09 usb device port.SchDoc

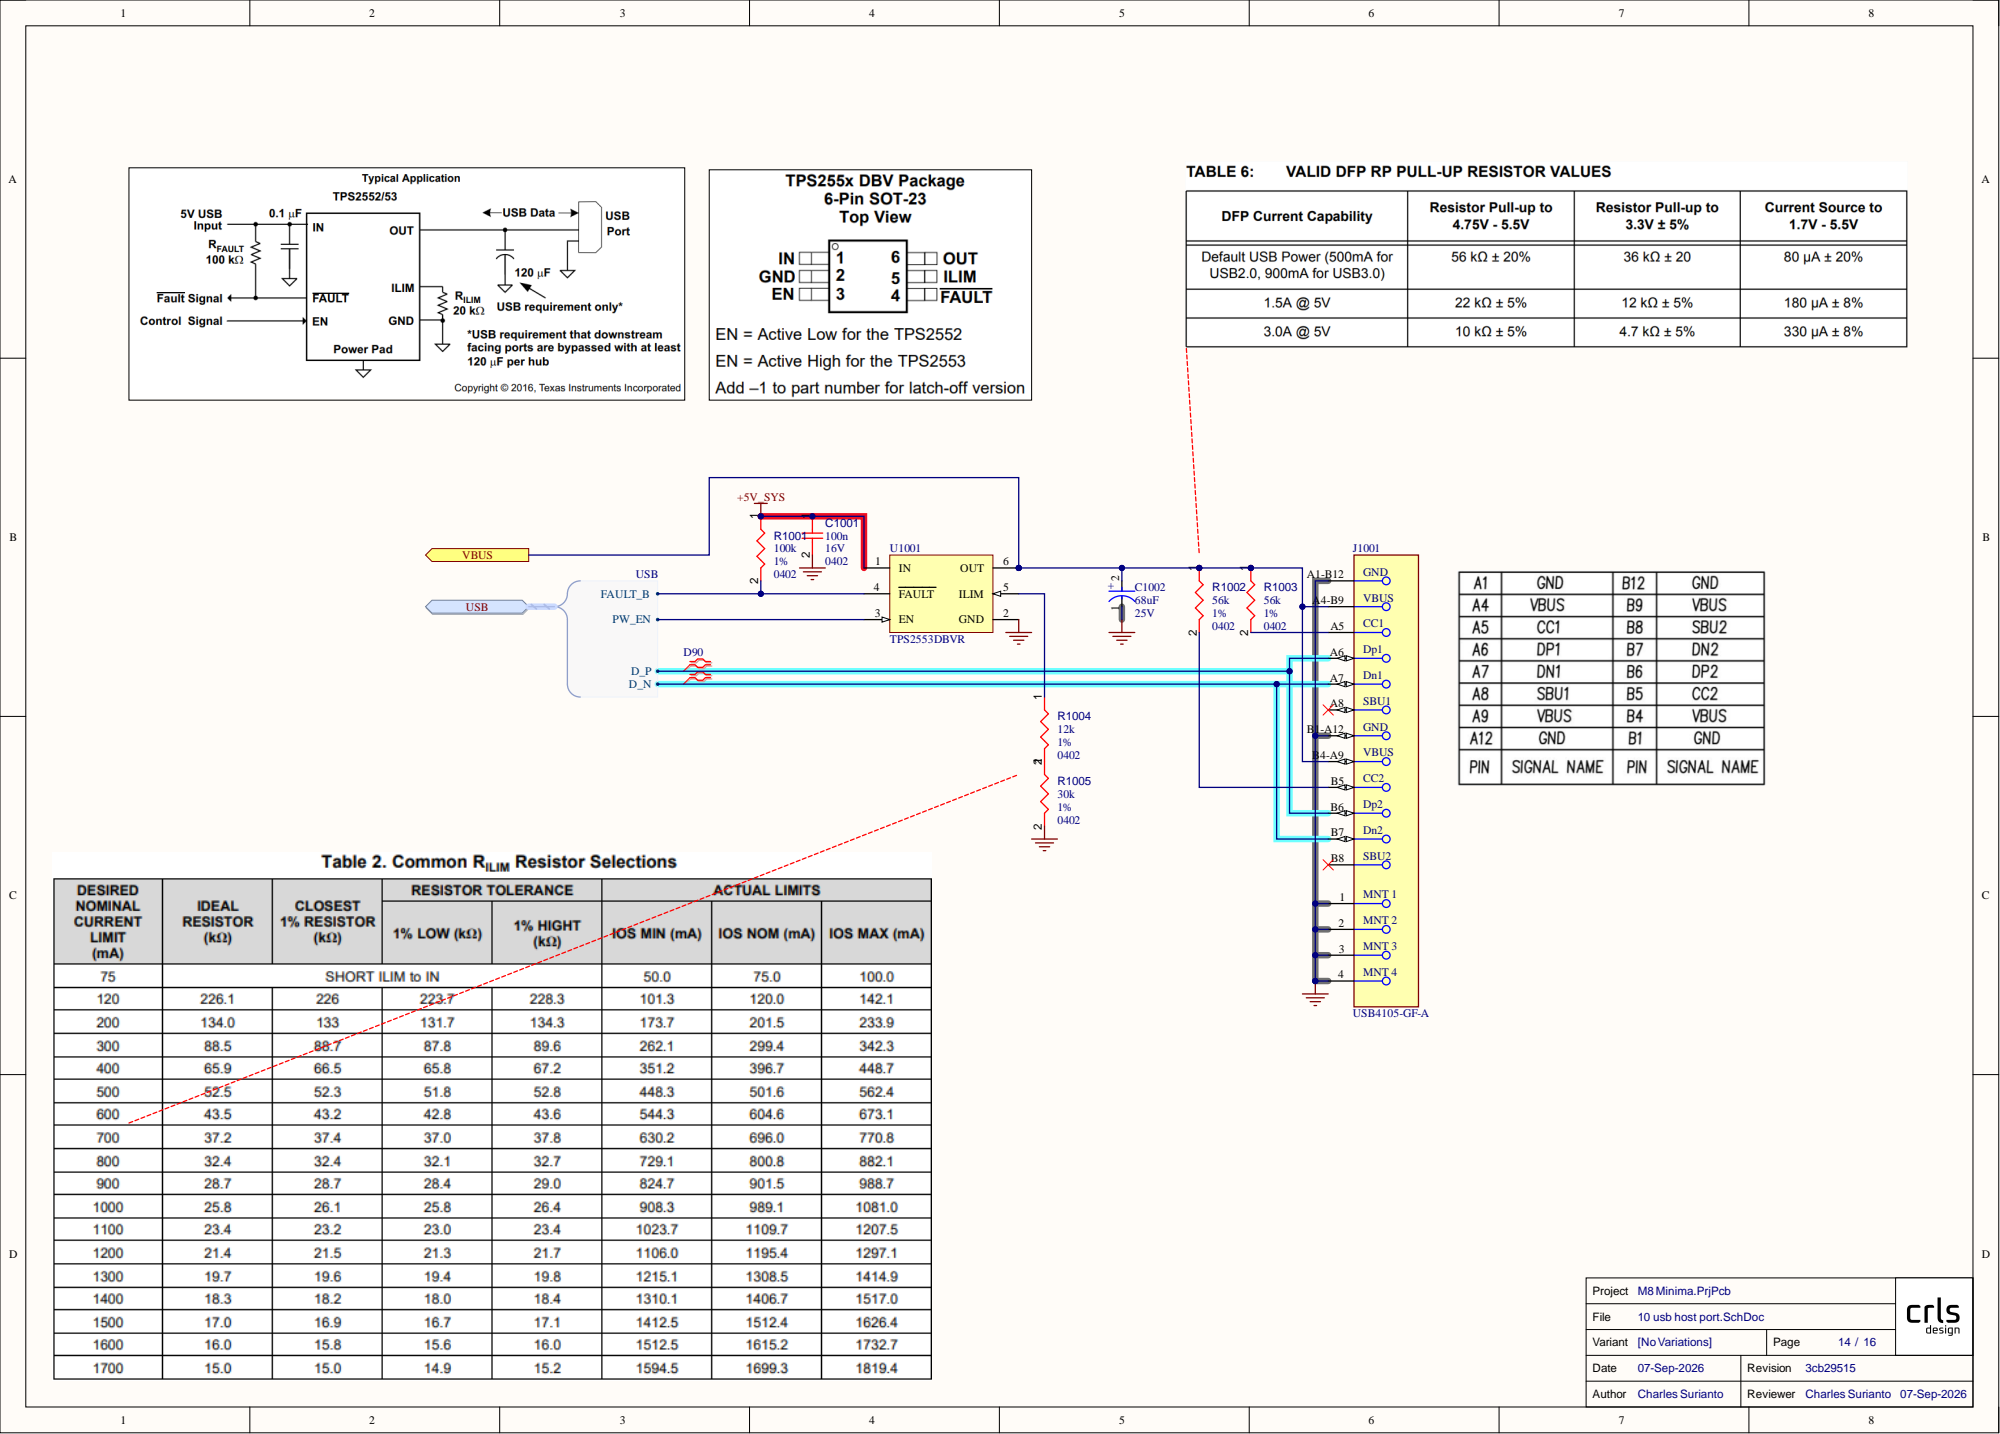
[picture p18: page 14]

10 usb host port.SchDoc

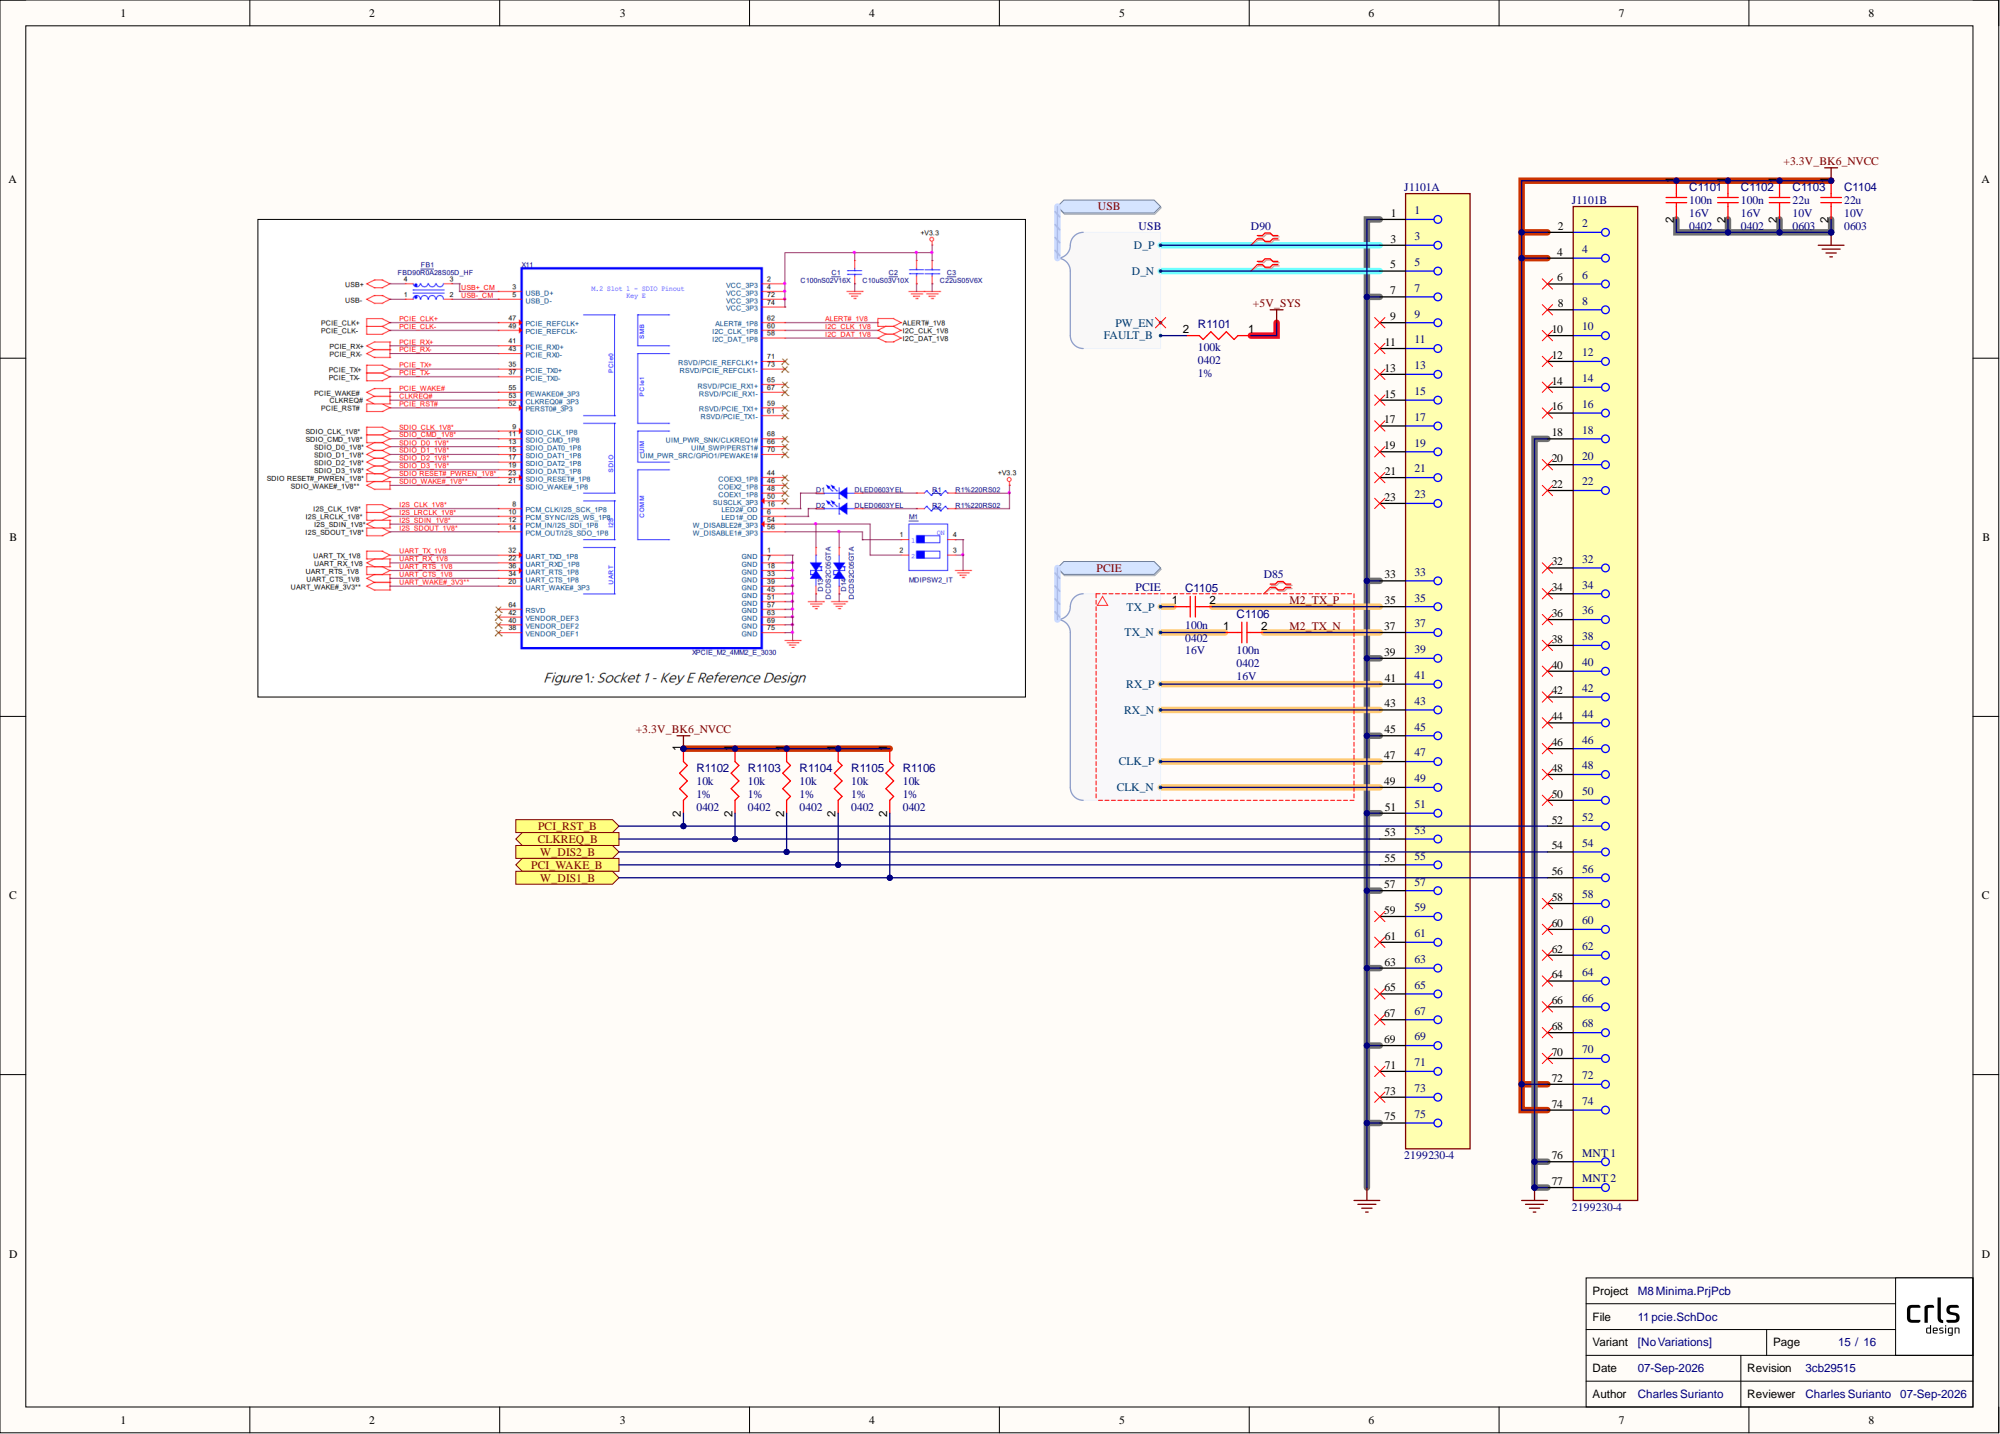
[picture p19: page 15]

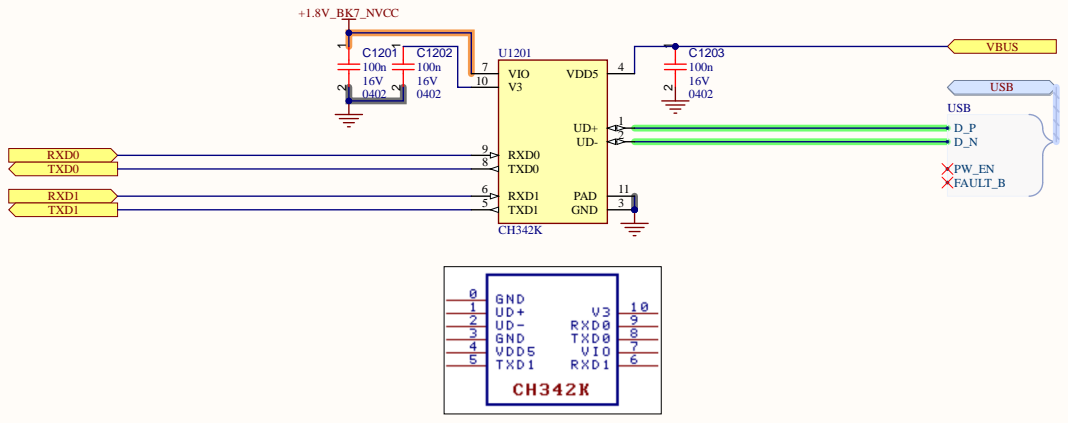
[picture p20: page 16]

1 6 V | 1 6 V | 1 0
0 4 0 2
