crls-design/M8-Minima/(list of files, drawings)

Other design files:
hardware/M8 Minima/01 top.SchDoc
hardware/M8 Minima/02 power input.SchDoc
hardware/M8 Minima/03 pmic.SchDoc
hardware/M8 Minima/04-1 m8 power.SchDoc
hardware/M8 Minima/04-2 m8 io 1.SchDoc
hardware/M8 Minima/04-3 m8 io 2.SchDoc
hardware/M8 Minima/04-4 m8 boot config.SchDoc
hardware/M8 Minima/05 lpddr4 ram.SchDoc
hardware/M8 Minima/06 ethernet.SchDoc
hardware/M8 Minima/07 flash.SchDoc
hardware/M8 Minima/08 usb hub.SchDoc
hardware/M8 Minima/09 usb device port.SchDoc
hardware/M8 Minima/10 usb host port.SchDoc
hardware/M8 Minima/11 pcie.SchDoc
hardware/M8 Minima/12 uart.SchDoc
hardware/M8 Minima/A1 power map.SchDoc
hardware/M8 Minima/M8 Minima.PcbLib
hardware/M8 Minima/M8 Minima.PrjPcb
hardware/M8 Minima/M8 Minima.SchLib
hardware/M8 Minima/panel.PcbDoc
