crls-design/M8-Minima/bsp/modules/uboot-imx/board/crls/m8_minima/spl.c

// SPDX-License-Identifier: GPL-2.0+
/*
 * Copyright 2019, 2021 NXP
 */

#include <command.h>
#include <cpu_func.h>
#include <hang.h>
#include <image.h>
#include <init.h>
#include <log.h>
#include <spl.h>
#include <asm/global_data.h>
#include <asm/io.h>
#include <asm/mach-imx/iomux-v3.h>
#include <asm/arch/clock.h>
#include <asm/arch/imx8mm_pins.h>
#include <asm/arch/sys_proto.h>
#include <asm/mach-imx/boot_mode.h>
#include <asm/arch/ddr.h>
#include <asm/sections.h>

#include <power/pmic.h>
#ifdef CONFIG_POWER_PCA9450
#include <power/pca9450.h>
#else
#include <power/bd71837.h>
#endif
#include <asm/mach-imx/gpio.h>
#include <asm/mach-imx/mxc_i2c.h>
#include <fsl_esdhc_imx.h>
#include <mmc.h>
#include <linux/delay.h>
#include <fsl_sec.h>

DECLARE_GLOBAL_DATA_PTR;

int spl_board_boot_device(enum boot_device boot_dev_spl)
{
	switch (boot_dev_spl) {
	case USB_BOOT:
		return BOOT_DEVICE_BOARD;
	case SD1_BOOT:
	case MMC1_BOOT:
		return BOOT_DEVICE_MMC1;
	case SD2_BOOT:
	case MMC2_BOOT:
		return BOOT_DEVICE_MMC2;
	case QSPI_BOOT:
		return BOOT_DEVICE_NOR;
	case NAND_BOOT:
		return BOOT_DEVICE_NAND;
	default:
		return BOOT_DEVICE_NONE;
	}
}

void spl_dram_init(void)
{
	ddr_init(&dram_timing);
}

#define I2C_PAD_CTRL	(PAD_CTL_DSE6 | PAD_CTL_HYS | PAD_CTL_PUE | PAD_CTL_PE)
#define PC MUX_PAD_CTRL(I2C_PAD_CTRL)
struct i2c_pads_info i2c_pad_info1 = {
	.scl = {
		.i2c_mode = IMX8MM_PAD_I2C1_SCL_I2C1_SCL | PC,
		.gpio_mode = IMX8MM_PAD_I2C1_SCL_GPIO5_IO14 | PC,
		.gp = IMX_GPIO_NR(5, 14),
	},
	.sda = {
		.i2c_mode = IMX8MM_PAD_I2C1_SDA_I2C1_SDA | PC,
		.gpio_mode = IMX8MM_PAD_I2C1_SDA_GPIO5_IO15 | PC,
		.gp = IMX_GPIO_NR(5, 15),
	},
};

#define USDHC_PAD_CTRL	(PAD_CTL_DSE6 | PAD_CTL_HYS | PAD_CTL_PUE |PAD_CTL_PE | \
			 PAD_CTL_FSEL2)

static iomux_v3_cfg_t const usdhc1_pads[] = {
	IMX8MM_PAD_SD1_CLK_USDHC1_CLK | MUX_PAD_CTRL(USDHC_PAD_CTRL),
	IMX8MM_PAD_SD1_CMD_USDHC1_CMD | MUX_PAD_CTRL(USDHC_PAD_CTRL),
	IMX8MM_PAD_SD1_DATA0_USDHC1_DATA0 | MUX_PAD_CTRL(USDHC_PAD_CTRL),
	IMX8MM_PAD_SD1_DATA1_USDHC1_DATA1 | MUX_PAD_CTRL(USDHC_PAD_CTRL),
	IMX8MM_PAD_SD1_DATA2_USDHC1_DATA2 | MUX_PAD_CTRL(USDHC_PAD_CTRL),
	IMX8MM_PAD_SD1_DATA3_USDHC1_DATA3 | MUX_PAD_CTRL(USDHC_PAD_CTRL),
	IMX8MM_PAD_SD1_DATA4_USDHC1_DATA4 | MUX_PAD_CTRL(USDHC_PAD_CTRL),
	IMX8MM_PAD_SD1_DATA5_USDHC1_DATA5 | MUX_PAD_CTRL(USDHC_PAD_CTRL),
	IMX8MM_PAD_SD1_DATA6_USDHC1_DATA6 | MUX_PAD_CTRL(USDHC_PAD_CTRL),
	IMX8MM_PAD_SD1_DATA7_USDHC1_DATA7 | MUX_PAD_CTRL(USDHC_PAD_CTRL),
	IMX8MM_PAD_SD1_STROBE_USDHC1_STROBE | MUX_PAD_CTRL(USDHC_PAD_CTRL),
};

static iomux_v3_cfg_t const usdhc2_pads[] = {
	IMX8MM_PAD_SD2_CLK_USDHC2_CLK | MUX_PAD_CTRL(USDHC_PAD_CTRL),
	IMX8MM_PAD_SD2_CMD_USDHC2_CMD | MUX_PAD_CTRL(USDHC_PAD_CTRL),
	IMX8MM_PAD_SD2_DATA0_USDHC2_DATA0 | MUX_PAD_CTRL(USDHC_PAD_CTRL),
	IMX8MM_PAD_SD2_DATA1_USDHC2_DATA1 | MUX_PAD_CTRL(USDHC_PAD_CTRL),
	IMX8MM_PAD_SD2_DATA2_USDHC2_DATA2 | MUX_PAD_CTRL(USDHC_PAD_CTRL),
	IMX8MM_PAD_SD2_DATA3_USDHC2_DATA3 | MUX_PAD_CTRL(USDHC_PAD_CTRL),
};

static struct fsl_esdhc_cfg usdhc_cfg[2] = {
	{USDHC1_BASE_ADDR, 0, 8},
	{USDHC2_BASE_ADDR, 0, 4},
};

int board_mmc_init(struct bd_info *bis)
{
	int i, ret;
	/*
	 * According to the board_mmc_init() the following map is done:
	 * (U-Boot device node)    (Physical Port)
	 * mmc0                    USDHC1
	 * mmc1                    USDHC2
	 */
	for (i = 0; i < CFG_SYS_FSL_USDHC_NUM; i++) {
		switch (i) {
		case 0:
			init_clk_usdhc(0);
			usdhc_cfg[0].sdhc_clk = mxc_get_clock(MXC_ESDHC_CLK);
			imx_iomux_v3_setup_multiple_pads(
				usdhc1_pads, ARRAY_SIZE(usdhc1_pads));
			break;
		case 1:
			init_clk_usdhc(1);
			usdhc_cfg[1].sdhc_clk = mxc_get_clock(MXC_ESDHC2_CLK);
			imx_iomux_v3_setup_multiple_pads(
				usdhc2_pads, ARRAY_SIZE(usdhc2_pads));
			break;
		default:
			printf("Warning: you configured more USDHC controllers"
				"(%d) than supported by the board\n", i + 1);
			return -EINVAL;
		}

		ret = fsl_esdhc_initialize(bis, &usdhc_cfg[i]);
		if (ret)
			return ret;
	}

	return 0;
}

int board_mmc_getcd(struct mmc *mmc)
{
	struct fsl_esdhc_cfg *cfg = (struct fsl_esdhc_cfg *)mmc->priv;
	int ret = 0;

	return cfg->esdhc_base == USDHC1_BASE_ADDR ||
	       cfg->esdhc_base == USDHC2_BASE_ADDR;
}

#if CONFIG_IS_ENABLED(POWER_LEGACY)
#define I2C_PMIC	0
#ifdef CONFIG_POWER_PCA9450
int power_init_board(void)
{
	struct pmic *p;
	int ret;

	ret = power_pca9450_init(I2C_PMIC, 0x25);
	if (ret)
		printf("power init failed");
	p = pmic_get("PCA9450");
	pmic_probe(p);

	/* BUCKxOUT_DVS0/1 control BUCK123 output */
	pmic_reg_write(p, PCA9450_BUCK123_DVS, 0x29);

	/* Buck 1 DVS control through PMIC_STBY_REQ */
	pmic_reg_write(p, PCA9450_BUCK1CTRL, 0x59);

	/* Set DVS1 to 0.8v for suspend */
	pmic_reg_write(p, PCA9450_BUCK1OUT_DVS1, 0x10);

	/* increase VDD_DRAM to 0.95v for 3Ghz DDR */
	pmic_reg_write(p, PCA9450_BUCK3OUT_DVS0, 0x1C);

	/* VDD_DRAM needs off in suspend, set B1_ENMODE=10 (ON by PMIC_ON_REQ = H && PMIC_STBY_REQ = L) */
	pmic_reg_write(p, PCA9450_BUCK3CTRL, 0x4a);

	/* set VDD_SNVS_0V8 from default 0.85V */
	pmic_reg_write(p, PCA9450_LDO2CTRL, 0xC0);

	/* set WDOG_B_CFG to cold reset */
	pmic_reg_write(p, PCA9450_RESET_CTRL, 0xA1);

	return 0;
}
#else
int power_init_board(void)
{
	struct pmic *p;
	int ret;

	ret = power_bd71837_init(I2C_PMIC);
	if (ret)
		printf("power init failed");

	p = pmic_get("BD71837");
	pmic_probe(p);


	/* decrease RESET key long push time from the default 10s to 10ms */
	pmic_reg_write(p, BD718XX_PWRONCONFIG1, 0x0);

	/* unlock the PMIC regs */
	pmic_reg_write(p, BD718XX_REGLOCK, 0x1);

	/* increase VDD_SOC to typical value 0.85v before first DRAM access */
	pmic_reg_write(p, BD718XX_BUCK1_VOLT_RUN, 0x0f);

	/* increase VDD_DRAM to 0.975v for 3Ghz DDR */
	pmic_reg_write(p, BD718XX_1ST_NODVS_BUCK_VOLT, 0x83);

#ifndef CONFIG_IMX8M_LPDDR4
	/* increase NVCC_DRAM_1V2 to 1.2v for DDR4 */
	pmic_reg_write(p, BD718XX_4TH_NODVS_BUCK_VOLT, 0x28);
#endif

	/* lock the PMIC regs */
	pmic_reg_write(p, BD718XX_REGLOCK, 0x11);

	return 0;
}
#endif
#endif

void spl_board_init(void)
{
	if (IS_ENABLED(CONFIG_FSL_CAAM)) {
		if (sec_init())
			printf("\nsec_init failed!\n");
	}
	puts("Normal Boot\n");
}

#ifdef CONFIG_SPL_LOAD_FIT
int board_fit_config_name_match(const char *name)
{
	/* Just empty function now - can't decide what to choose */
	debug("%s: %s\n", __func__, name);

	return 0;
}
#endif

void board_init_f(ulong dummy)
{
	int ret;

	/* Clear the BSS. */
	memset(__bss_start, 0, __bss_end - __bss_start);

	arch_cpu_init();

	board_early_init_f();

	timer_init();

	preloader_console_init();

	ret = spl_init();
	if (ret) {
		debug("spl_init() failed: %d\n", ret);
		hang();
	}

	enable_tzc380();

	/* Adjust pmic voltage to 1.0V for 800M */
	setup_i2c(0, CONFIG_SYS_I2C_SPEED, 0x7f, &i2c_pad_info1);

	power_init_board();

	/* DDR initialization */
	spl_dram_init();

	board_init_r(NULL, 0);
}
