crls-design/M8-Minima/(commit log)

2026-09-15 add design files
    [01 top.SchDoc, 02 power input.SchDoc, 03 pmic.SchDoc, 04-1 m8 power.SchDoc, 04-2 m8 io 1.SchDoc, 04-3 m8 io 2.SchDoc, 04-4 m8 boot config.SchDoc, 05 lpddr4 ram.SchDoc]
2026-09-15 add schematic print
2026-09-22 adjust capacitor clearance to eliminate solder bridge
2026-09-27 add 3D model for CH342K
    [M8 Minima.PcbLib]
2026-09-27 fix phy reset logic level issue by remapping it to a pin in I2C domain
    [04-3 m8 io 2.SchDoc, 06 ethernet.SchDoc]
2026-10-15 Add M8 Minima build scripts and resources
    - Introduced new scripts for building the M8 Minima kernel, bootloader, and SD card image.
    - Added design review Excel file and various image assets for the project.
    - Implemented `build-kernel-m8-minima.sh` for kernel compilation with device tree support.
    - Created `build-m8-minima.sh` to orchestrate fetching sources and building bootloader and kernel.
    - Developed `build-sdcard-m8-minima.sh` for creating a bootable SD card image with Debian arm64 root filesystem.
    - Added `fetch-sources-m8-minima.sh` to clone upstream repositories and apply overlays.
    - Included `package-m8-minima.sh` for packaging U-Boot and related firmware into a flashable binary.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
